seethc/IIB_project_FUTURE/CAD/Gemini_Generated_Image_v84o97v84o97v84o.png

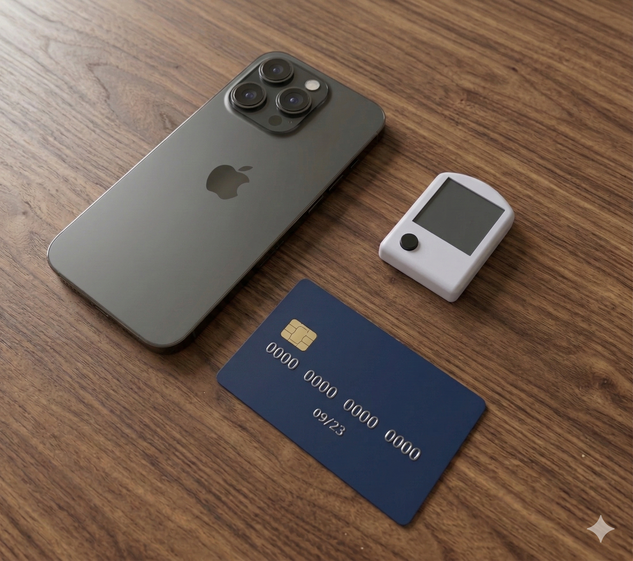
CAD/Gemini_Generated_Image_v84o97v84o97v84o.png
