seethc/IIB_project_FUTURE/misc_figures/current_sleep.png

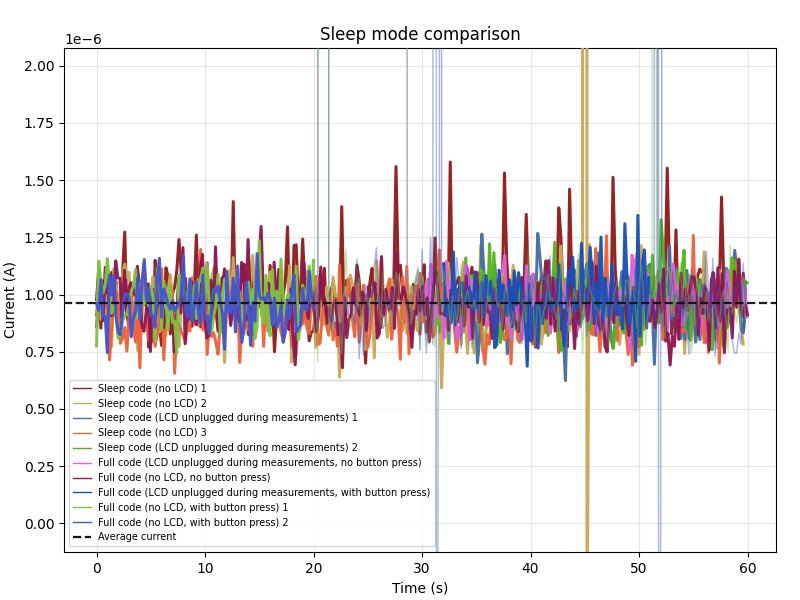
misc_figures/current_sleep.png
