seethc/IIB_project_FUTURE/README.md

# IIB_project_FUTURE
TOTP implementation for an ATtiny1616 based keyfob device and a Raspberry Pi based clinical-side backend.
