seethc/IIB_project_FUTURE/CAD/CompleteSystem.JPG

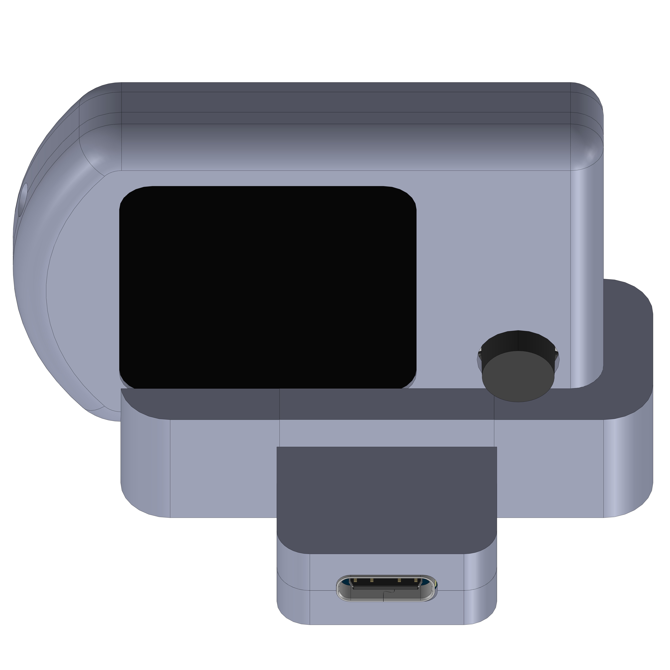
CAD/CompleteSystem.JPG
