seethc/IIB_project_FUTURE/CAD/CompleteSystemExploded.JPG

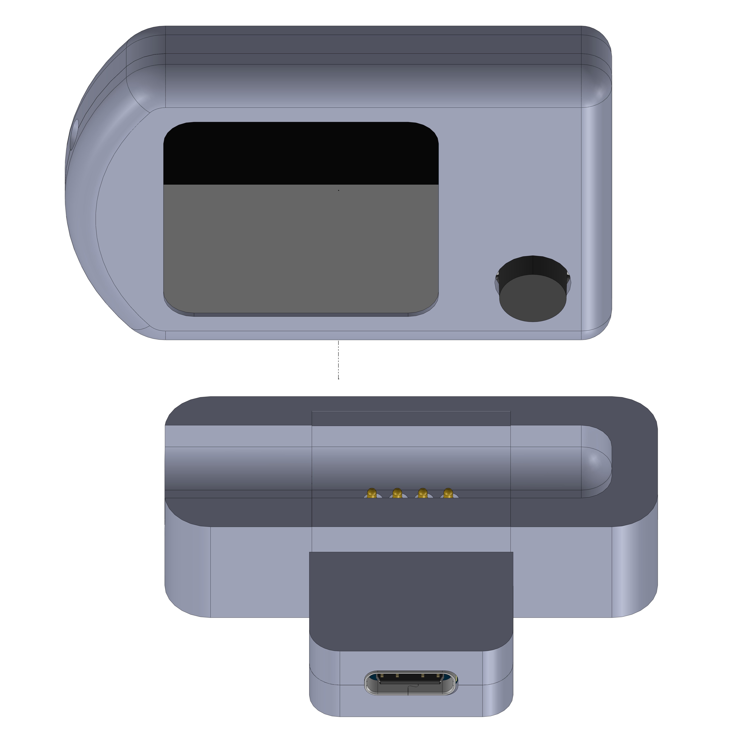
CAD/CompleteSystemExploded.JPG
