seethc/IIB_project_FUTURE/CAD/CompleteSystemTransparent.JPG

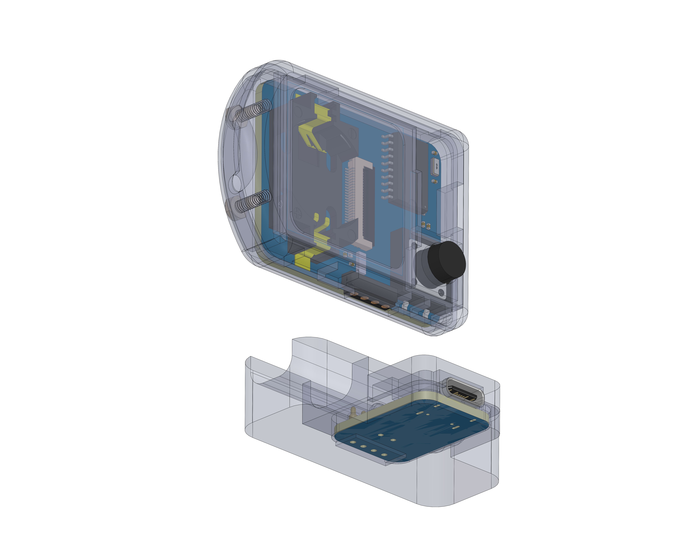
CAD/CompleteSystemTransparent.JPG
