seethc/IIB_project_FUTURE/CAD/DockedSystem.JPG

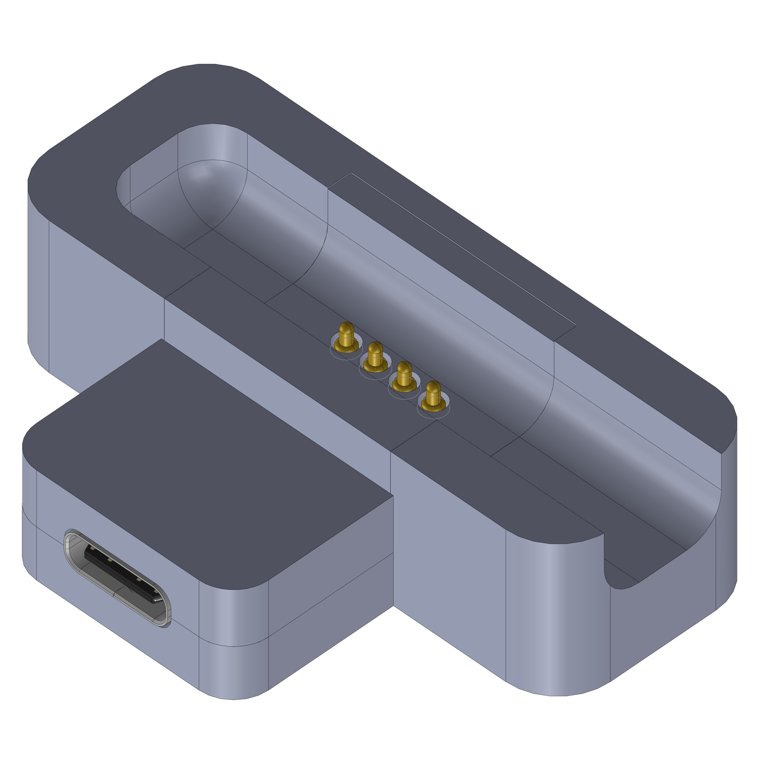
CAD/DockedSystem.JPG
