seethc/IIB_project_FUTURE/CAD/DockedSystemExploded.JPG

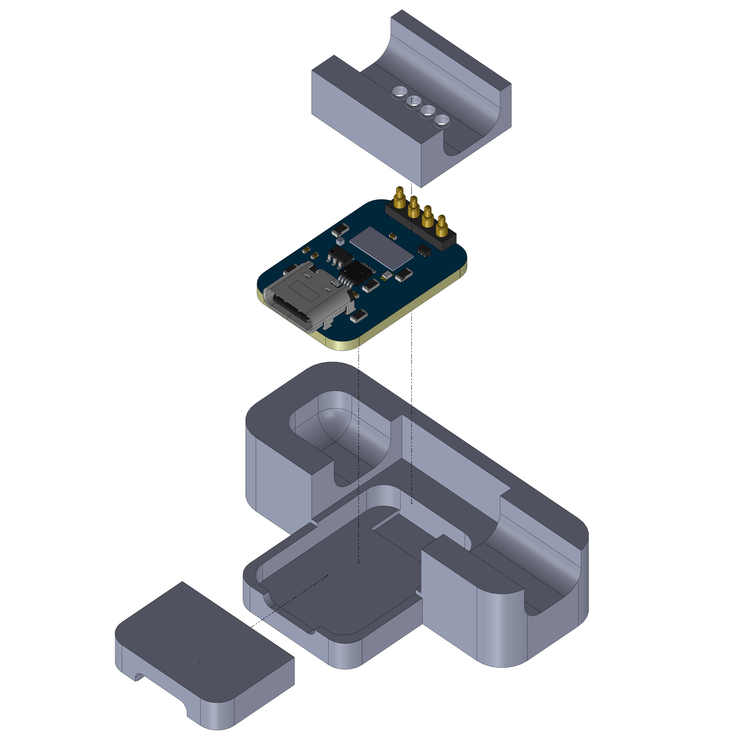
CAD/DockedSystemExploded.JPG
