seethc/IIB_project_FUTURE/CAD/IntegratedFob.JPG

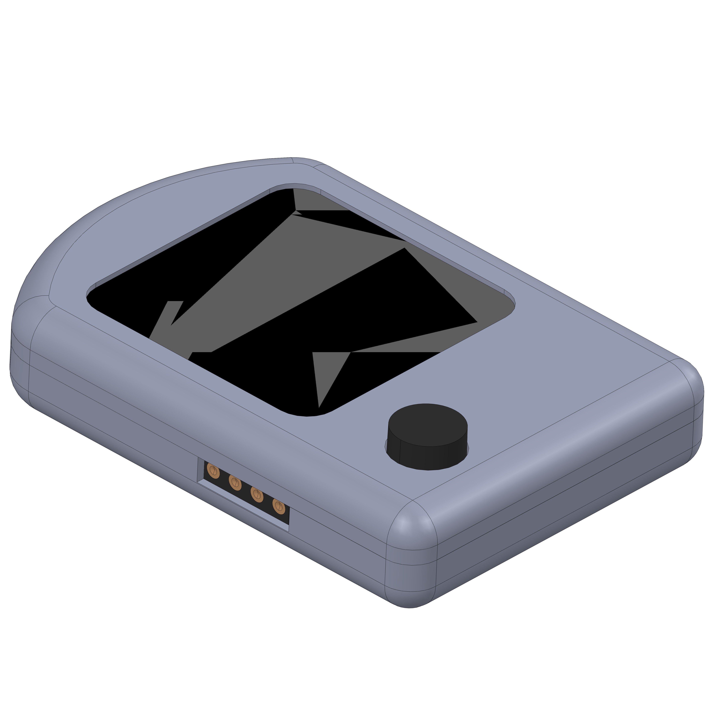
CAD/IntegratedFob.JPG
