seethc/IIB_project_FUTURE/CAD/IntegratedFobExploded.JPG

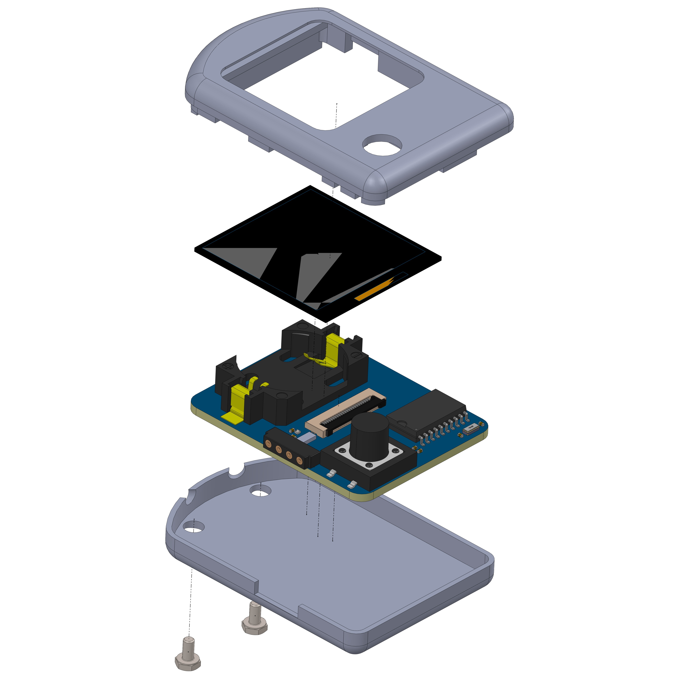
CAD/IntegratedFobExploded.JPG
