seethc/IIB_project_FUTURE/CAD/TransparentSystem.JPG

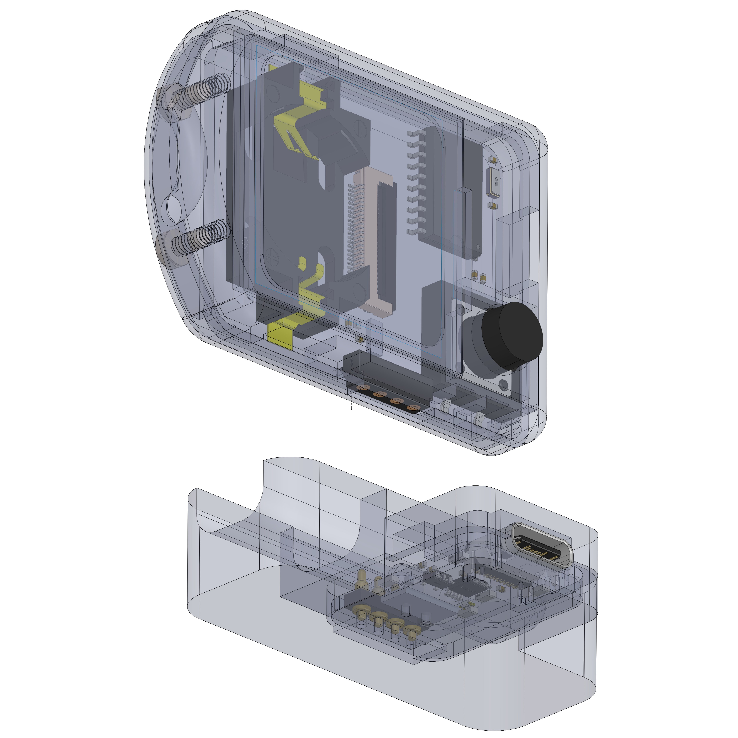
CAD/TransparentSystem.JPG
