seethc/IIB_project_FUTURE/misc_figures/combined.png

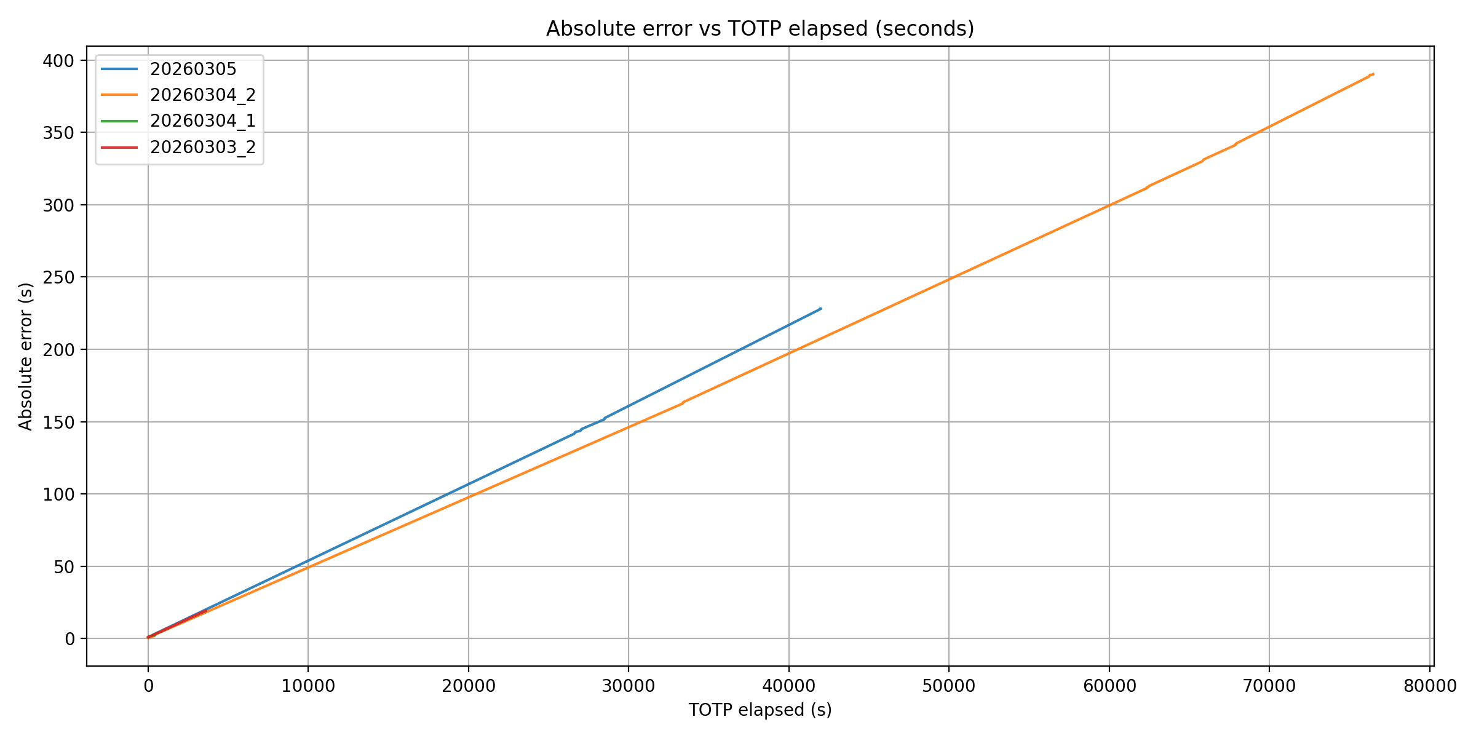
misc_figures/combined.png
