seethc/IIB_project_FUTURE/misc_figures/combined_rms.png

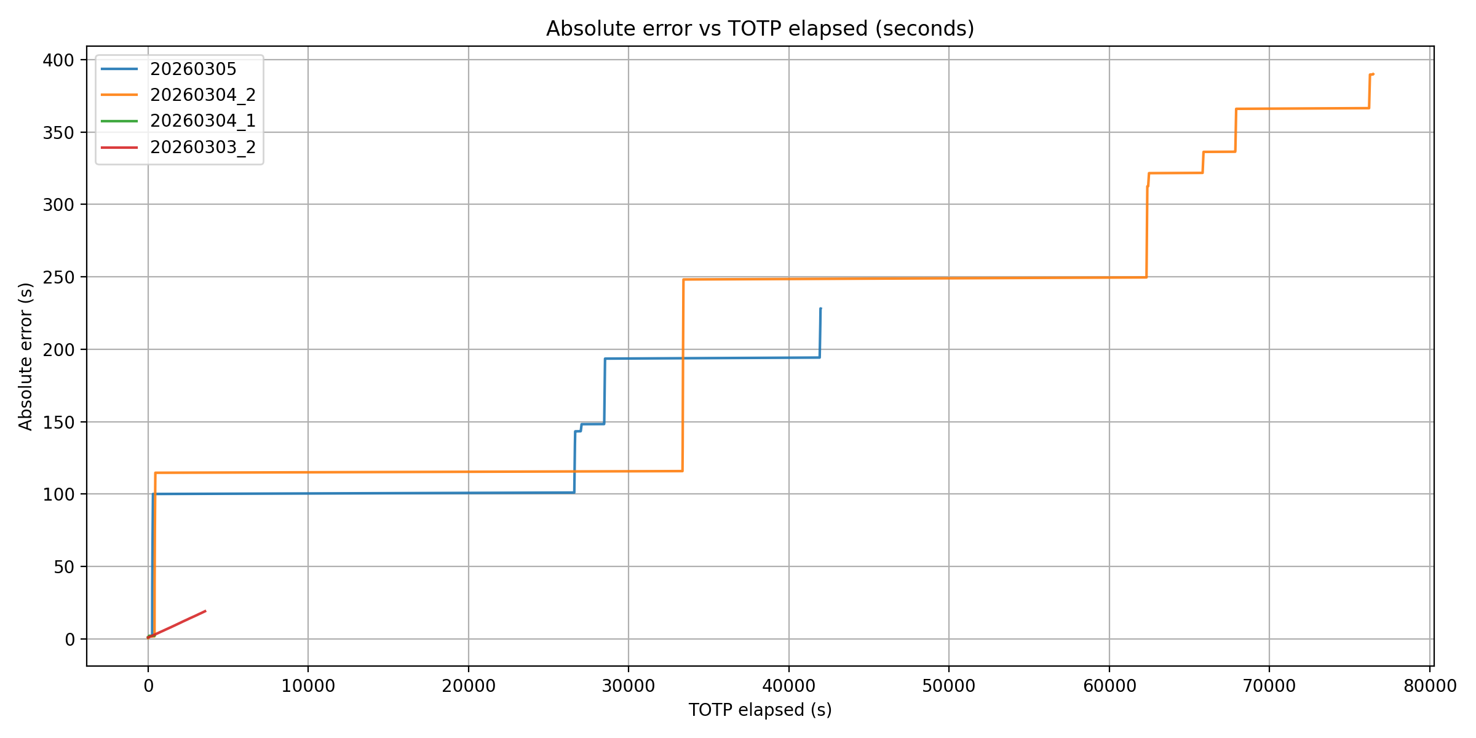
misc_figures/combined_rms.png
