seethc/IIB_project_FUTURE/misc_figures/current_crypto_display.png

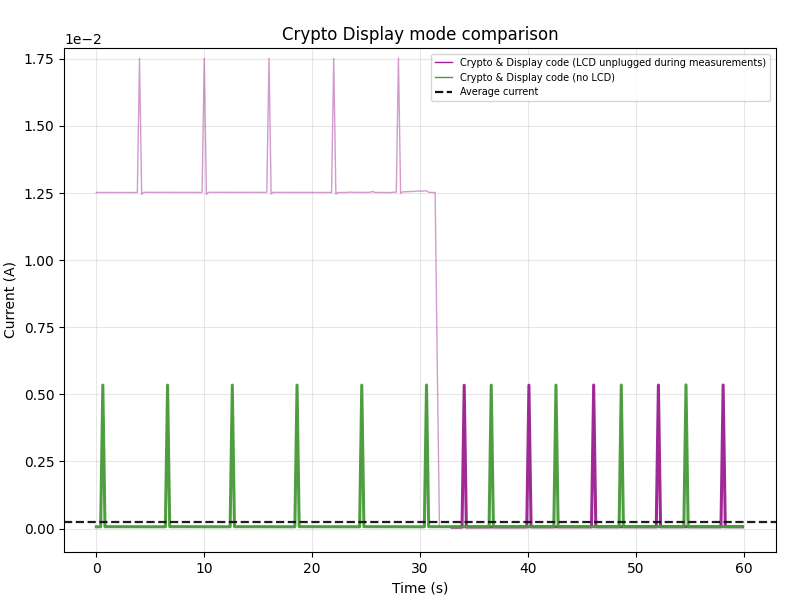
misc_figures/current_crypto_display.png
