seethc/IIB_project_FUTURE/misc_figures/current_crypto_only2.png

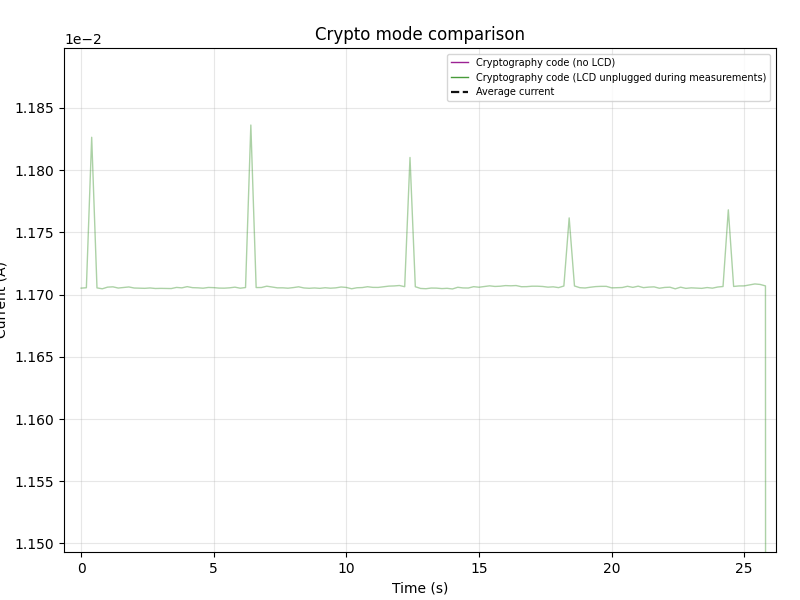
misc_figures/current_crypto_only2.png
