seethc/IIB_project_FUTURE/misc_figures/current_crypto_only.png

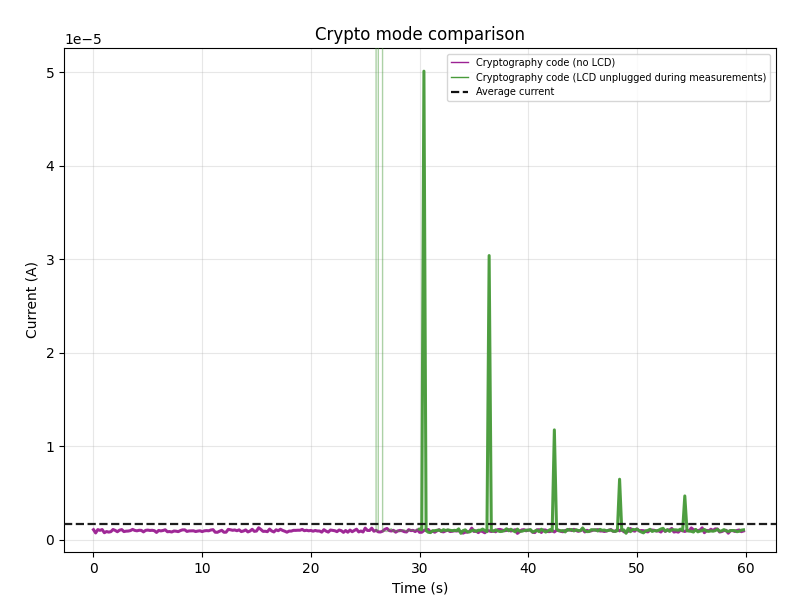
misc_figures/current_crypto_only.png
