seethc/IIB_project_FUTURE/misc_figures/current_numbers.png

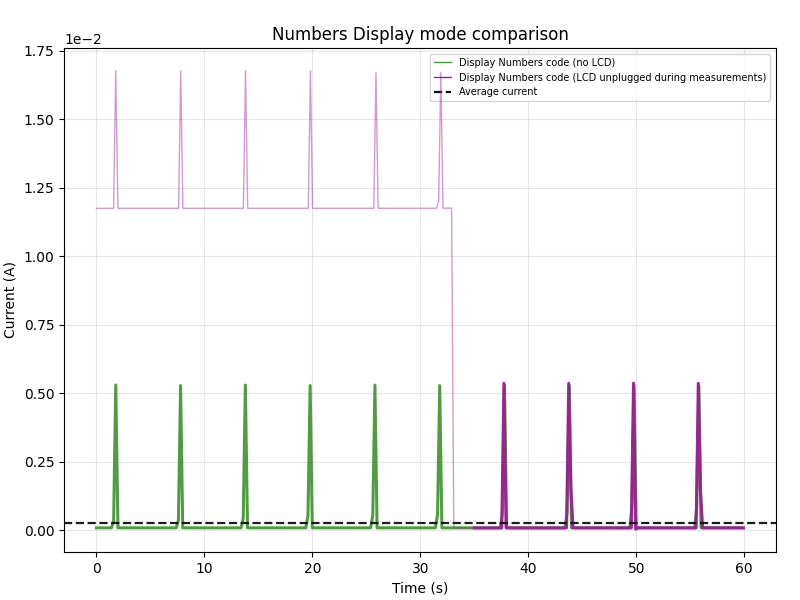
misc_figures/current_numbers.png
