seethc/IIB_project_FUTURE/misc_figures/current_shapes.png

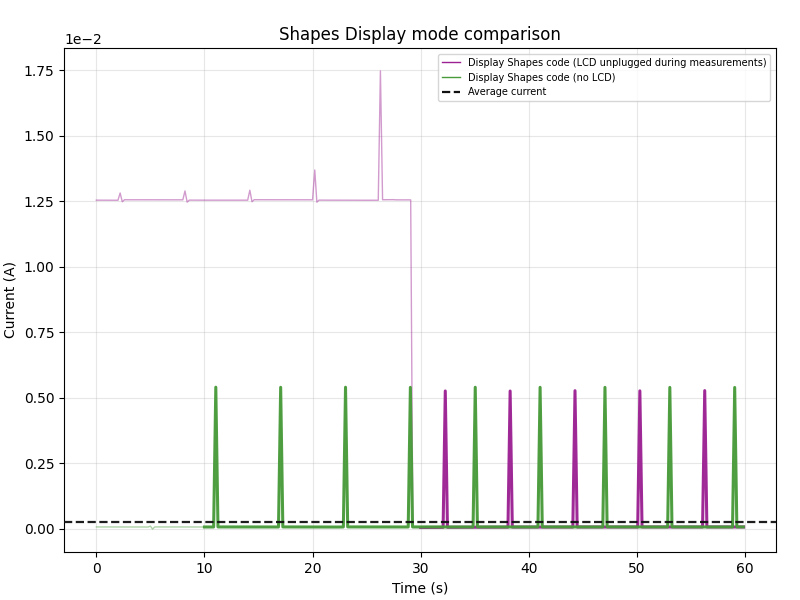
misc_figures/current_shapes.png
