seethc/IIB_project_FUTURE/misc_figures/Figure_1.png

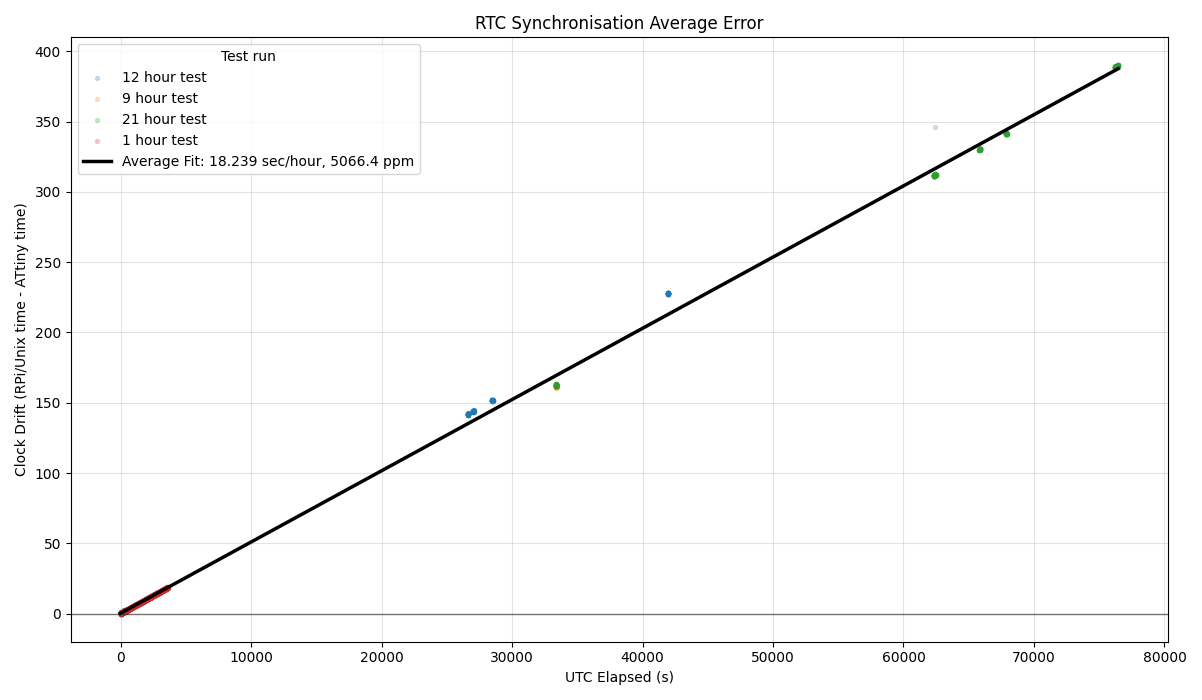
misc_figures/Figure_1.png
