seethc/IIB_project_FUTURE/misc_figures/Figure_2.png

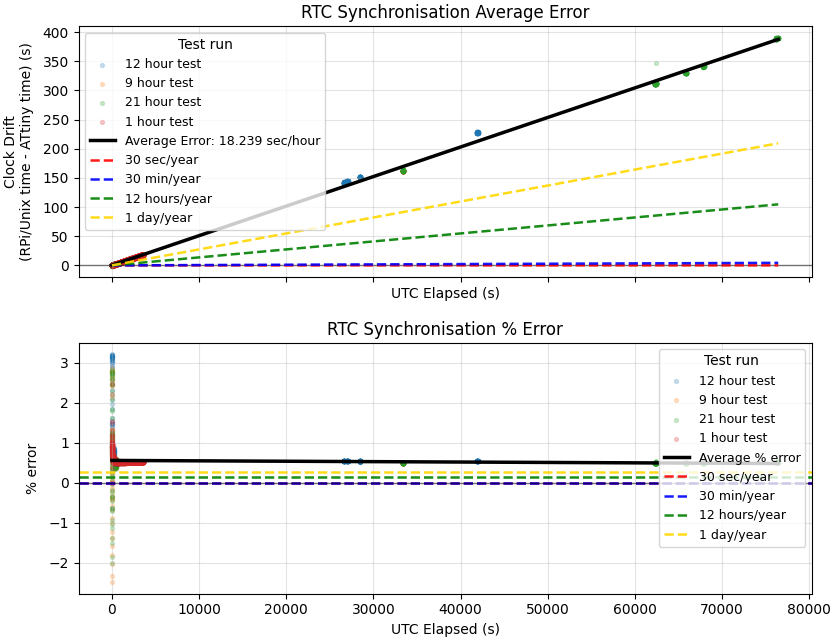
misc_figures/Figure_2.png
