seethc/IIB_project_FUTURE/misc_figures/Figure_2_tall.png

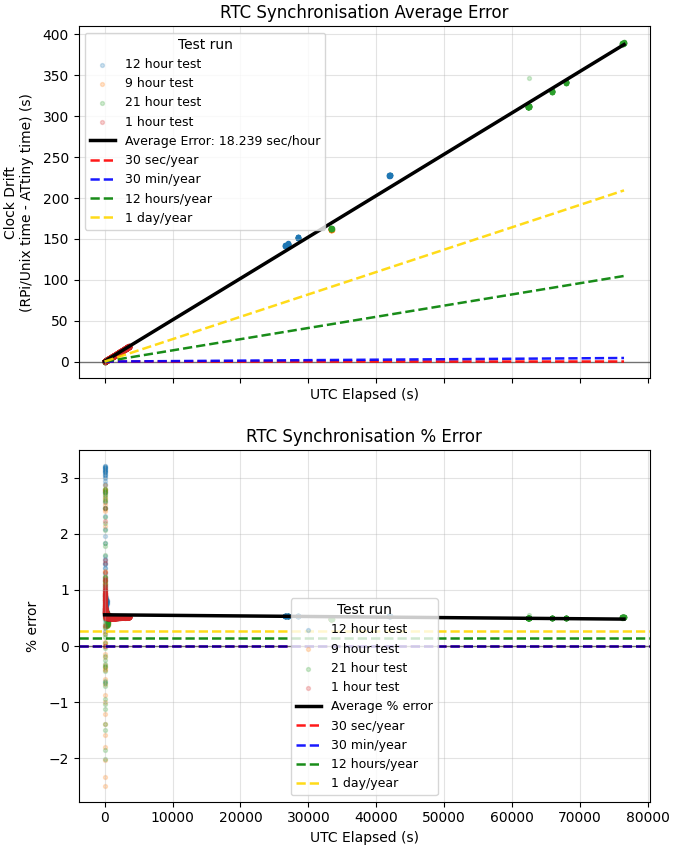
misc_figures/Figure_2_tall.png
