seethc/IIB_project_FUTURE/CAD/USB_case_top_alpha.STL

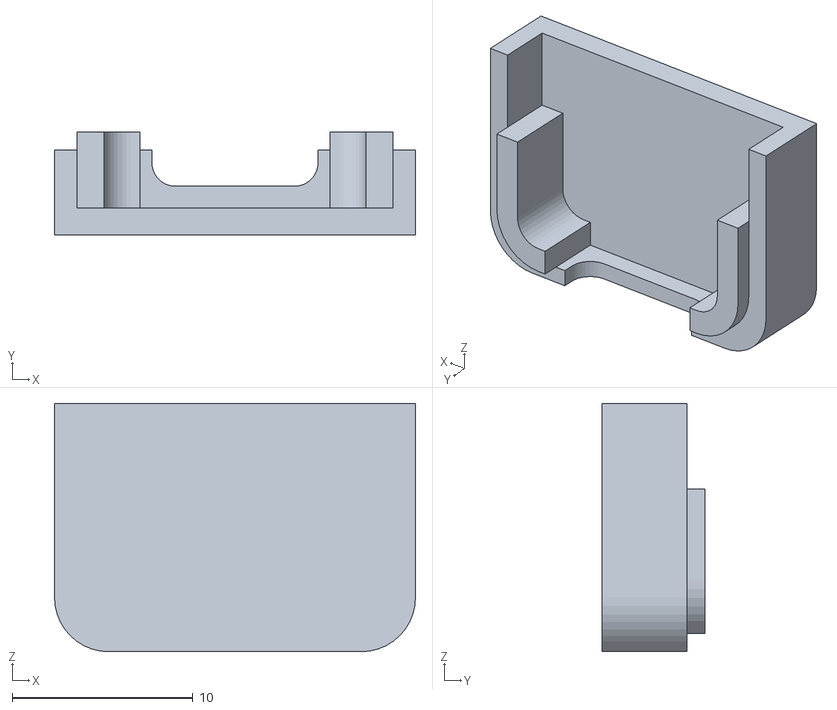
[picture p42: CAD file, 2026-05-31]
CAD/USB_case_top_alpha.STL
20.0 x 5.70 x 13.8
