seethc/IIB_project_FUTURE/CAD/LCD.SLDPRT

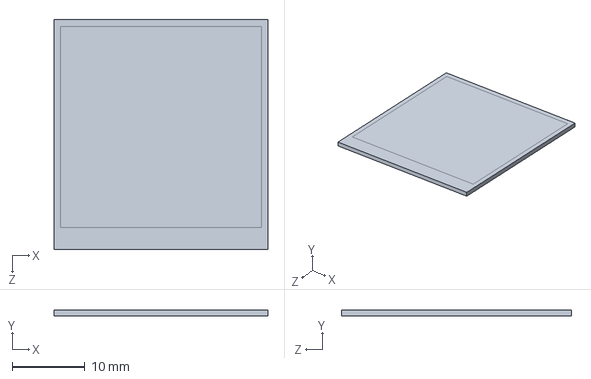
[picture p43: CAD file, 2026-05-31]
CAD/LCD.SLDPRT
29.5 x 0.8 x 31.7 mm
