seethc/IIB_project_FUTURE/CAD/USB_bottom.SLDPRT

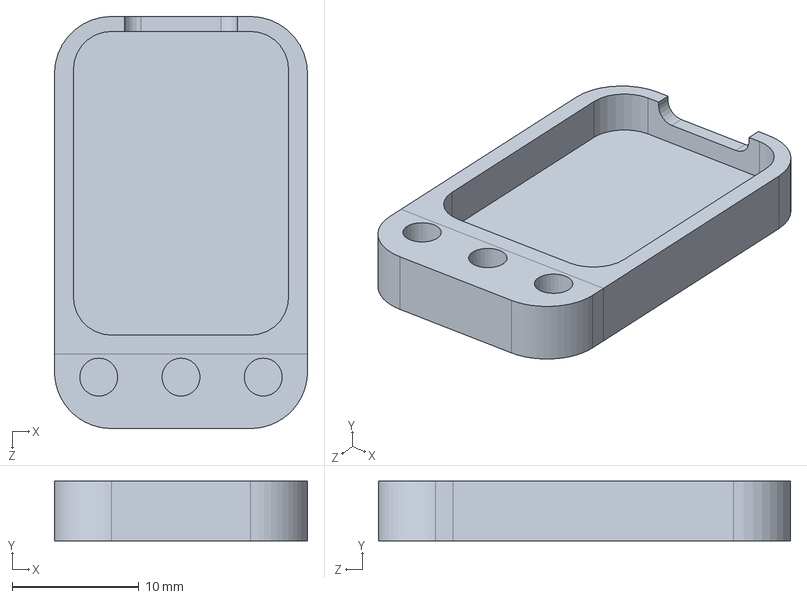
[picture p44: CAD file, 2026-05-31]
CAD/USB_bottom.SLDPRT
20.0 x 4.73 x 32.6 mm
