seethc/IIB_project_FUTURE/CAD/USB_case_bottom.SLDPRT

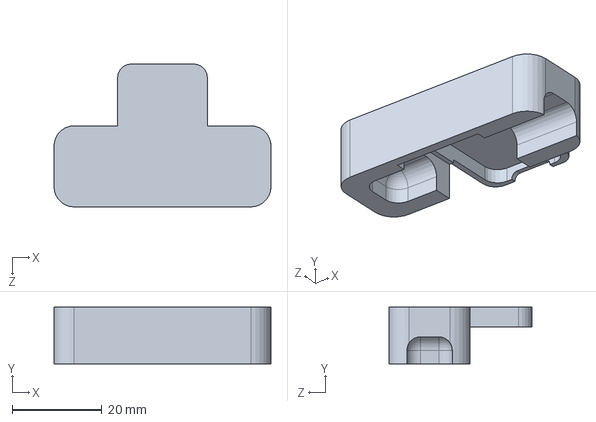
[picture p45: CAD file, 2026-05-31]
CAD/USB_case_bottom.SLDPRT
48.4 x 12.6 x 31.9 mm
