seethc/IIB_project_FUTURE/CAD/pendant_top_correct2.SLDPRT

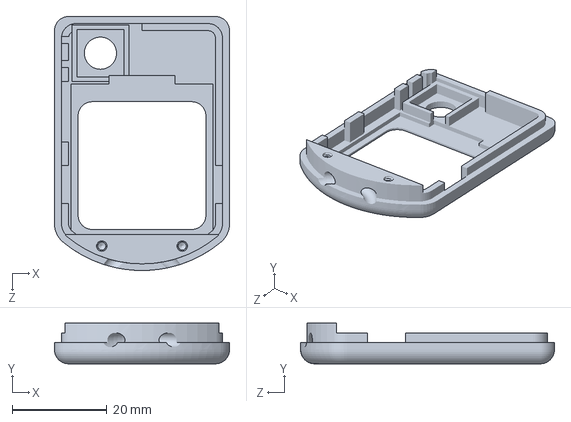
[picture p46: CAD file, 2026-05-31]
CAD/pendant_top_correct2.SLDPRT
37.0 x 8.60 x 53.7 mm
