seethc/IIB_project_FUTURE/CAD/lcd_base.SLDPRT

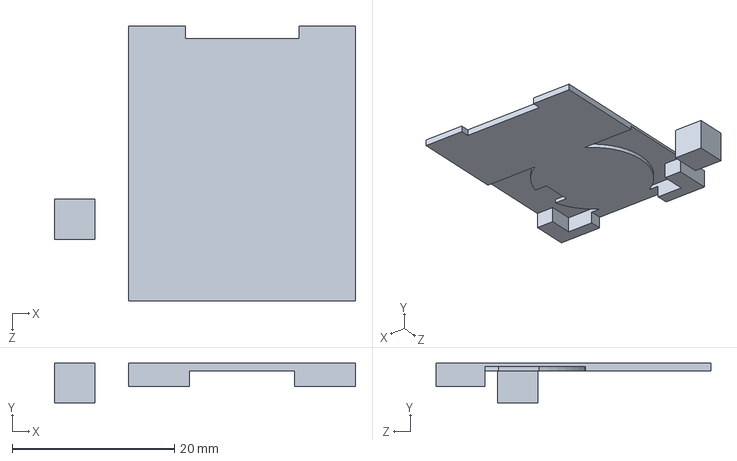
[picture p47: CAD file, 2026-05-31]
CAD/lcd_base.SLDPRT
37.1 x 4.90 x 33.9 mm
