seethc/IIB_project_FUTURE/CAD/pendant.SLDPRT

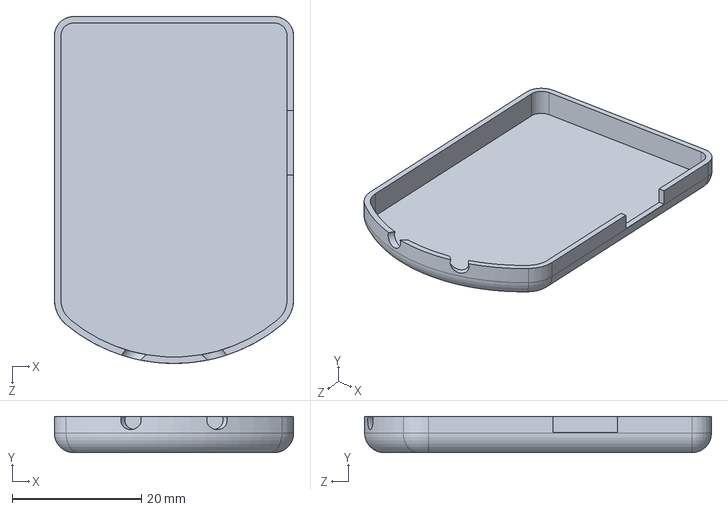
[picture p48: CAD file, 2026-05-31]
CAD/pendant.SLDPRT
37.0 x 5.60 x 53.7 mm
