seethc/IIB_project_FUTURE/CAD/UM3E_pendant.3mf

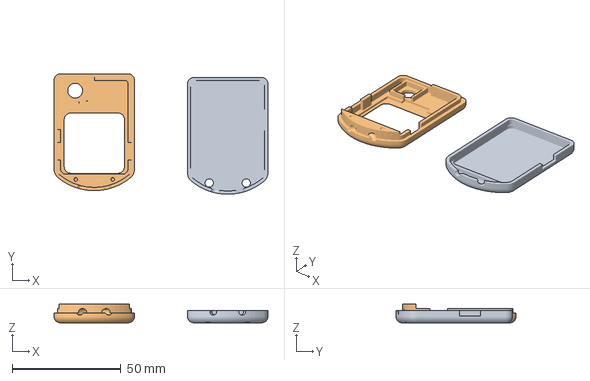
[picture p49: CAD file, 2026-05-31]
CAD/UM3E_pendant.3mf
98.3 x 55.3 x 8.60 mm
pendant.STL
pendant_top_correct.STL
