seethc/IIB_project_FUTURE/CAD/pendant_top_alpha.STL

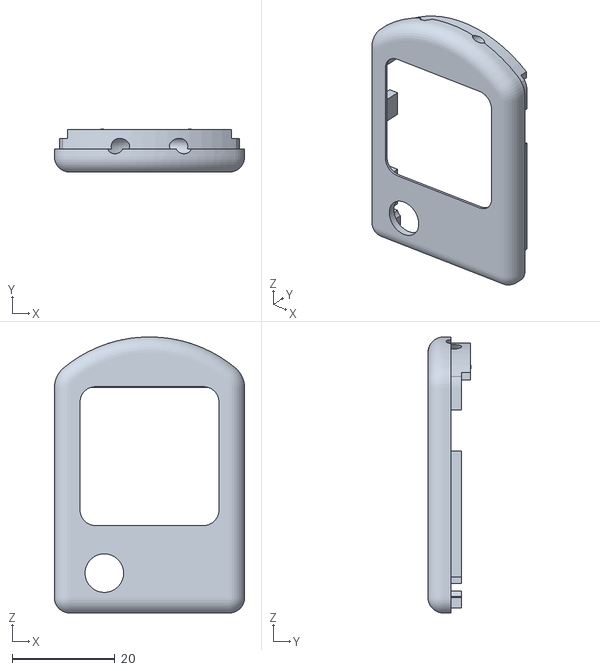
[picture p50: CAD file, 2026-05-31]
CAD/pendant_top_alpha.STL
37.0 x 8.39 x 53.6
