seethc/IIB_project_FUTURE/CAD/pendant_top.SLDPRT

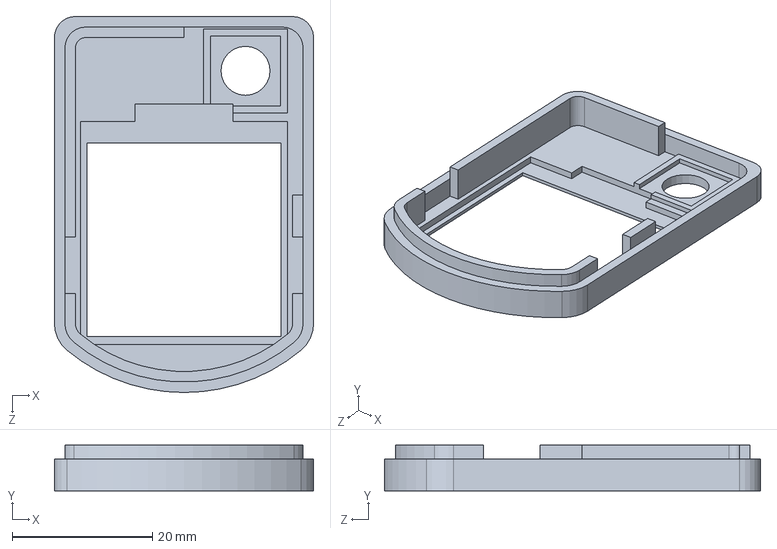
[picture p51: CAD file, 2026-05-31]
CAD/pendant_top.SLDPRT
37.0 x 6.50 x 53.7 mm
