seethc/IIB_project_FUTURE/CAD/3D_PCB_PCB_3216_fob_compact_2026-03-06_2026-03-06.step

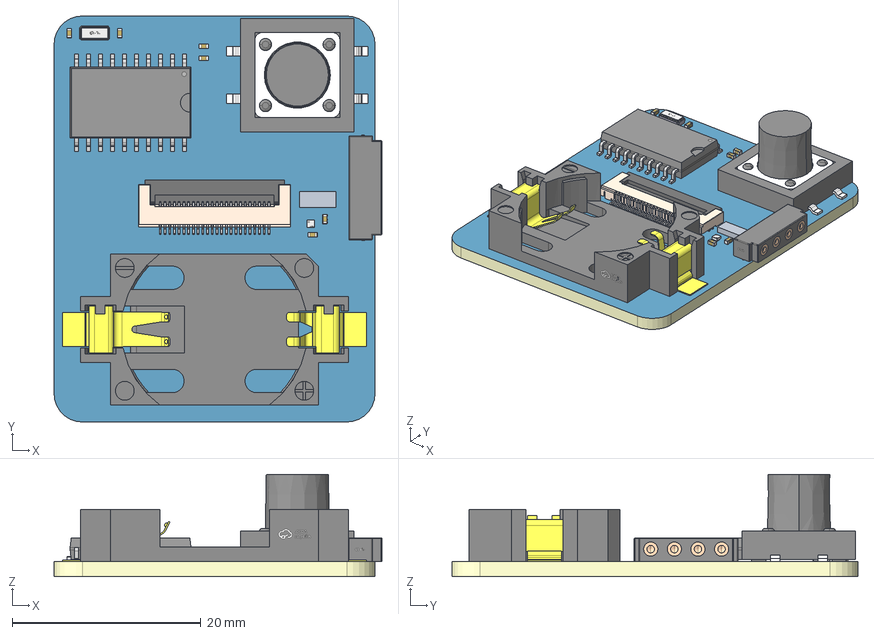
[picture p52: CAD file, 2026-05-31]
CAD/3D_PCB_PCB_3216_fob_compact_2026-03-06_2026-03-06.step
34.7 x 43.0 x 10.8 mm
Board~JCCK
TopCopper~JCCK
BottomCopper~JCCK
TopFpcStiffener~JCCK
BottomFpcStiffener~JCCK
SOD-123_L2.7-W1.6-LS3.7-RD-1~SOD-123_L2.7-W1.6-LS3.7-RD-1~JCCK
SOIC-20_L12.8-W7.5-P1.27-LS10.3-BL~SOIC-20_ L12.8-W7.5-P1.27-LS10.3-BL~JCCK
WLCSP-4_L0.8-W0.8-R2-C2-P0.40-BL~WLCSP-4_L0.8-W0.8-H0.6-P0.4~JCCK
C0402~C0402_L1.0-W0.5-H0.5~JCCK x 6
CONN-SMD_YZ199315035T-04025-01~CONN-SMD_YZ199315035T-04025-01~JCCK
OSC-SMD_L3.2-W1.5~OSC-SMD_L3.2-W1.5-H0.8~JCCK
SW-SMD_4P-L12.0-W12.0-P5.00-LS15.0~SW-SMD_ 4P-L12.0-W12.0-P5.00-LS15.0~JCCK
BAT-SMD_CR2032-B1~BAT-SMD_CR2032-B1~JCCK
FPC-SMD_24P-P0.50_C5373439~FPC-SMD_24P-P0.50_C5373439~JCCK
