seethc/IIB_project_FUTURE/CAD/USB_pendant_holder.SLDPRT

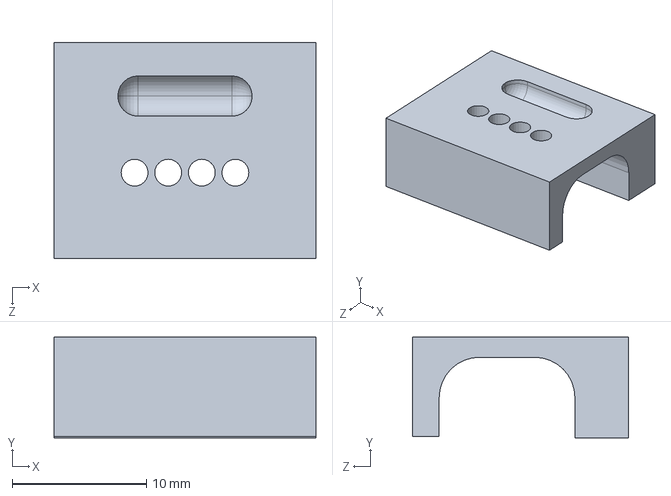
[picture p54: CAD file, 2026-05-31]
CAD/USB_pendant_holder.SLDPRT
19.5 x 7.50 x 16.1 mm
