seethc/IIB_project_FUTURE/CAD/USB_top.SLDPRT

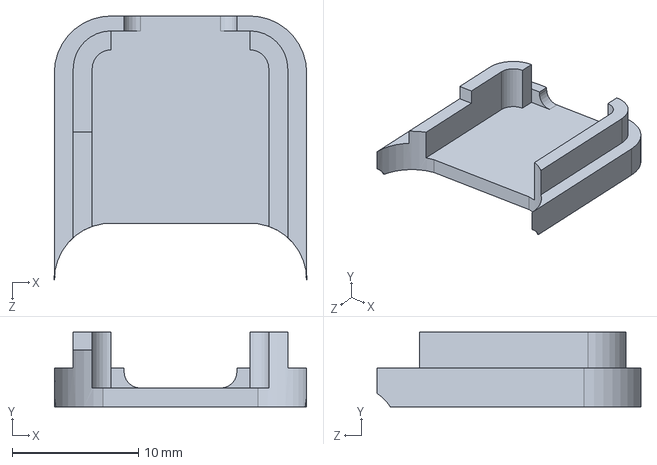
[picture p55: CAD file, 2026-05-31]
CAD/USB_top.SLDPRT
20.0 x 5.94 x 20.9 mm
