seethc/IIB_project_FUTURE/CAD/scale_model_comparison.3mf

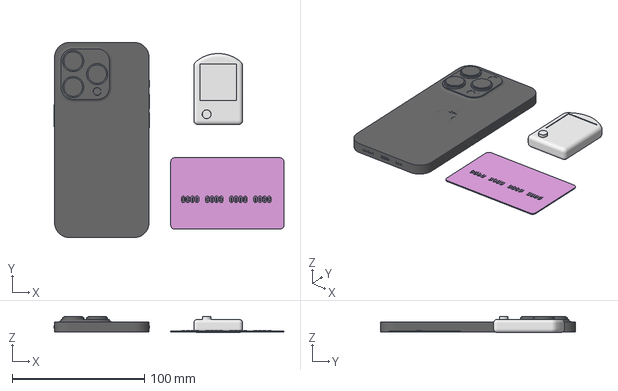
[picture p56: CAD file, 2026-05-31]
CAD/scale_model_comparison.3mf
173.8 x 147.5 x 12.3 mm
