seethc/IIB_project_FUTURE/CAD/3D_PCB_PCB_FUTURE_USB_adapter_2026-03-09_2026-03-09.step

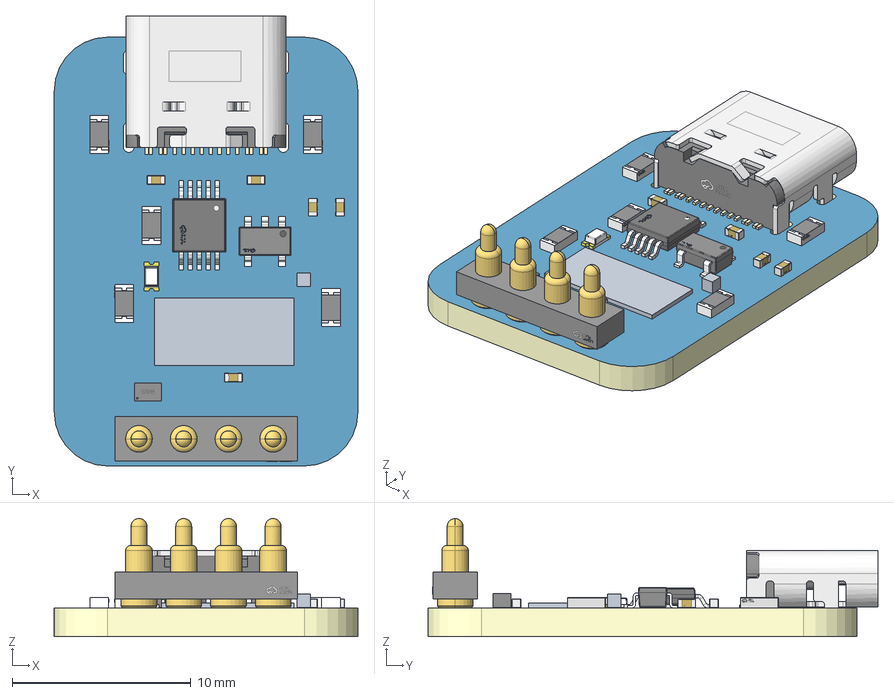
[picture p57: CAD file, 2026-05-31]
CAD/3D_PCB_PCB_FUTURE_USB_adapter_2026-03-09_2026-03-09.step
17.0 x 25.2 x 6.60 mm
Board~5WUN
TopCopper~5WUN
BottomCopper~5WUN
TopFpcStiffener~5WUN
BottomFpcStiffener~5WUN
C0402~C0402_L1.0-W0.5-H0.5~5WUN x 5
SW-SMD_MSS12C02LS-HB2.0-1~SW-SMD_MSS12C02LS-HB2.0-1~5WUN
MSOP-10_L3.0-W3.0-P0.50-LS5.0-BL~MSOP-10_ L3.0-W3.0-H1.1-LS5.0-P0.50~5WUN
R0603~R0603~5WUN x 5
LED0603-R-RD_WHITE~LED0603-R-RD_WHITE~5WUN
LED0603-RD~LED0603-RD~5WUN
SOT-23-5_L2.9-W1.6-P0.95-LS2.7-BR~SOT-23-5_ L2.9-W1.6-P0.95-LS2.7-BR~5WUN
DFN-6_L1.5-W1.0-P0.50-BL~DFN-6_L1.5-W1.0-H0.7-P0.50~5WUN
CONN-TH_YZ85915058P-04025-01~CONN-TH_YZ85915058P-04025-01~5WUN
TYPE-C-SMD_TYPE-C-3.1-16PIN~TYPE-C-SMD_TYPE-C-3.1-16PIN~5WUN
