seethc/IIB_project_FUTURE/CAD/DockedSystem.SLDASM

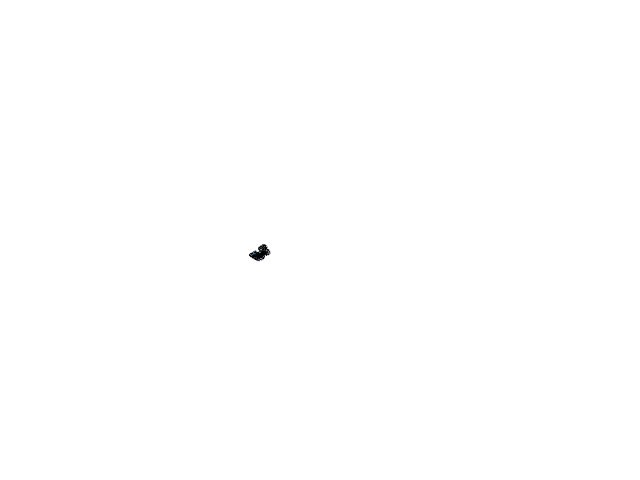
[picture p58: CAD file, 2026-05-31]
CAD/DockedSystem.SLDASM
C0402~C0402_L1.0-W0.5-H0.5~5WUN.step x 5
SW-SMD_MSS12C02LS-HB2.0-1~SW-SMD_MSS12C02LS-HB2.0-1~5WUN.step
MSOP-10_L3.0-W3.0-P0.50-LS5.0-BL~MSOP-10_L3.0-W3.0-H1.1-LS5.0-P0.50~5WUN.step
R0603~R0603~5WUN.step x 5
LED0603-R-RD_WHITE~LED0603-R-RD_WHITE~5WUN.step
LED0603-RD~LED0603-RD~5WUN.step
SOT-23-5_L2.9-W1.6-P0.95-LS2.7-BR~SOT-23-5_L2.9-W1.6-P0.95-LS2.7-BR~5WUN.step
DFN-6_L1.5-W1.0-P0.50-BL~DFN-6_L1.5-W1.0-H0.7-P0.50~5WUN.step
CONN-TH_YZ85915058P-04025-01~CONN-TH_YZ85915058P-04025-01~5WUN.step
TYPE-C-SMD_TYPE-C-3.1-16PIN~TYPE-C-SMD_TYPE-C-3.1-16PIN~5WUN.step
Board~5WUN.step
pendant
SOD-123_L2.7-W1.6-LS3.7-RD-1~SOD-123_L2.7-W1.6-LS3.7-RD-1~JCCK.step
SOIC-20_L12.8-W7.5-P1.27-LS10.3-BL~SOIC-20_L12.8-W7.5-P1.27-LS10.3-BL~JCCK.step
WLCSP-4_L0.8-W0.8-R2-C2-P0.40-BL~WLCSP-4_L0.8-W0.8-H0.6-P0.4~JCCK.step
C0402~C0402_L1.0-W0.5-H0.5~JCCK.step x 6
CONN-SMD_YZ199315035T-04025-01~CONN-SMD_YZ199315035T-04025-01~JCCK.step
OSC-SMD_L3.2-W1.5~OSC-SMD_L3.2-W1.5-H0.8~JCCK.step
SW-SMD_4P-L12.0-W12.0-P5.00-LS15.0~SW-SMD_4P-L12.0-W12.0-P5.00-LS15.0~JCCK.step
BAT-SMD_CR2032-B1~BAT-SMD_CR2032-B1~JCCK.step
FPC-SMD_24P-P0.50_C5373439~FPC-SMD_24P-P0.50_C5373439~JCCK.step
Board~JCCK.step
LCD
pendant_top_correct
hex screw gradeab_iso x 2
USB_pendant_holder
USB_case_top
USB_case_bottom_mirror
