seethc/IIB_project_FUTURE/CAD/USB_casing.SLDASM

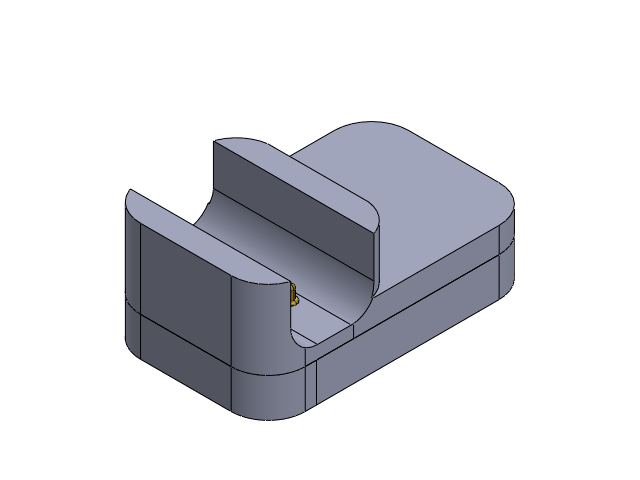
[picture p60: CAD file, 2026-05-31]
CAD/USB_casing.SLDASM
USB_bottom
C0402~C0402_L1.0-W0.5-H0.5~5WUN.step x 5
SW-SMD_MSS12C02LS-HB2.0-1~SW-SMD_MSS12C02LS-HB2.0-1~5WUN.step
MSOP-10_L3.0-W3.0-P0.50-LS5.0-BL~MSOP-10_L3.0-W3.0-H1.1-LS5.0-P0.50~5WUN.step
R0603~R0603~5WUN.step x 5
LED0603-R-RD_WHITE~LED0603-R-RD_WHITE~5WUN.step
LED0603-RD~LED0603-RD~5WUN.step
SOT-23-5_L2.9-W1.6-P0.95-LS2.7-BR~SOT-23-5_L2.9-W1.6-P0.95-LS2.7-BR~5WUN.step
DFN-6_L1.5-W1.0-P0.50-BL~DFN-6_L1.5-W1.0-H0.7-P0.50~5WUN.step
CONN-TH_YZ85915058P-04025-01~CONN-TH_YZ85915058P-04025-01~5WUN.step
TYPE-C-SMD_TYPE-C-3.1-16PIN~TYPE-C-SMD_TYPE-C-3.1-16PIN~5WUN.step
Board~5WUN.step
USB_top
