seethc/IIB_project_FUTURE/(list of files, cad)

Other CAD files:
CAD/pendant_bottom_final.STL
CAD/USB_case_top.SLDPRT
CAD/pendant_top_correct.SLDPRT
CAD/pendant_alpha.STL
CAD/USB_pendant_holder_alpha.STL
CAD/USB_case_bottom_alpha.STL
CAD/USB_case_bottom_mirror.SLDPRT
CAD/3D_PCB_PCB_3216_fob_compact_2026-03-06_2026-03-06.SLDASM
CAD/3D_PCB_PCB_3216_fob_compact_2026-03-06_2026-03-06.SLDDRW
CAD/3D_PCB_PCB_FUTURE_USB_adapter_2026-03-09_2026-03-09.SLDASM
CAD/3D_PCB_PCB_FUTURE_USB_adapter_2026-03-09_2026-03-09.SLDDRW
CAD/DockedSystem.SLDDRW
CAD/IntegratedFob.SLDDRW
CAD/IntegratedFob.SLDPRT
CAD/IntegratedFob.STL
CAD/USB_bottom.STL
CAD/USB_case_bottom.STL
CAD/USB_case_top.STL
CAD/USB_pendant_holder.3mf
CAD/USB_pendant_holder.STL
CAD/USB_top.3mf
CAD/USB_top.STL
CAD/lcd_base.STL
CAD/pendant.3mf
CAD/pendant.STL
CAD/pendant_top_correct.STL
CAD/pendant_top_correct2.STL
