seethc/IIB_project_FUTURE/VirtualBench_power_tests/FUTURE Calcs - Power.completed.csv

File | Total raw charge (mC) | Worst-case Min (mC) | Worst-case Max (mC) | Statistical Min (mC) | Statistical Max (mC) | Current Floor (A) | Area above floor (mC) | Worst-case Min (mC) | Worst-case Max (mC) | Statistical Min (mC) | Statistical Max (mC)
[01] current_log_20260326_154908.csv | sleep_only.ino with LCD unplugged halfway through | 316.958130 | 314.613744 | 319.302560 | 316.131224 | 317.785036 | 0.0000010190 | 316.898512 | 314.554867 | 319.242188 | 316.071654 | 317.725371
[02] current_log_20260326_155546.csv | sleep_with_overflow (PER = 19 so overflows every 20 ticks or 5s) no LCD | 0.060393 | 0.057824 | 0.063076 | 0.060262 | 0.060524 | 0.0000010069 | 0.002423 | 0.001089 | 0.003801 | 0.002349 | 0.002497
[04] current_log_20260326_155840.csv | sleep_with_overflow (PER = 19 so [05] overflows every 20 ticks or 5s) with LCD unplugged halfway through | 357.258018 | 354.909497 | 359.606587 | 356.435440 | 358.080597 | 0.0000009821 | 357.200248 | 354.852446 | 359.548076 | 356.377717 | 358.022779
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
