seethc/IIB_project_FUTURE/rtc_test_files/20260304_1/attiny_log_9h.xlsx

UTC Timestamp | TOTP Code | Elapsed HH:MM:SS | Elapsed (s) | UTC elapsed | CLK elapsed | Elapsed s
0:13:03 | 755224 | 0:00:00 | 0 | 9:16:52 | 9:15:03 | 9:15:03
0:13:05 | 287082 | 0:00:54 | 54
0:13:06 | 287082 | 0:00:55 | 55 | Error | % Error
0:13:07 | 287082 | 0:00:56 | 56 | 0:01:49 | 0.32686%
0:13:08 | 287082 | 0:00:57 | 57
0:13:09 | 287082 | 0:00:58 | 58 | Window | Time till TOTP desync
0:13:10 | 287082 | 0:00:59 | 59 | 1s | 0.003541025482 | 0d00:05:06
0:13:11 | 359152 | 0:01:00 | 60 | 60s | 0.2124615289 | 0d05:05:57
0:13:12 | 359152 | 0:01:01 | 61 | 30m | 6.373845867 | 6d08:58:20
0:13:13 | 359152 | 0:01:02 | 62 | 1h | 12.74769173 | 12d17:56:41
0:13:14 | 359152 | 0:01:03 | 63 | 6h | 76.4861504 | 76d11:40:03
0:13:15 | 359152 | 0:01:04 | 64 | 12h | 152.9723008 | 152d23:20:07
0:13:16 | 359152 | 0:01:05 | 65 | Daily | 305.94 | 305d22:40:14
0:13:17 | 359152 | 0:01:06 | 66
0:13:18 | 359152 | 0:01:07 | 67
0:13:19 | 359152 | 0:01:08 | 68 | Using the ULP internal CLK
0:13:20 | 359152 | 0:01:09 | 69
0:13:21 | 359152 | 0:01:10 | 70
0:13:22 | 359152 | 0:01:11 | 71
0:13:23 | 359152 | 0:01:12 | 72
0:13:24 | 359152 | 0:01:14 | 74
0:13:25 | 359152 | 0:01:15 | 75
0:13:26 | 359152 | 0:01:16 | 76
0:13:27 | 359152 | 0:01:17 | 77
0:13:28 | 359152 | 0:01:18 | 78
0:13:29 | 359152 | 0:01:19 | 79
0:13:30 | 359152 | 0:01:20 | 80
0:13:31 | 359152 | 0:01:21 | 81
0:13:32 | 359152 | 0:01:22 | 82
0:13:33 | 359152 | 0:01:23 | 83
0:13:34 | 359152 | 0:01:24 | 84
0:13:35 | 359152 | 0:01:25 | 85
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
9:29:34 | 461650 | 9:14:41 | 33281
9:29:35 | 461650 | 9:14:42 | 33282
9:29:36 | 461650 | 9:14:43 | 33283
9:29:37 | 461650 | 9:14:44 | 33284
9:29:38 | 461650 | 9:14:45 | 33285
9:29:39 | 461650 | 9:14:46 | 33286
9:29:40 | 461650 | 9:14:47 | 33287
9:29:41 | 461650 | 9:14:48 | 33288
9:29:42 | 461650 | 9:14:49 | 33289
9:29:43 | 461650 | 9:14:50 | 33290
9:29:44 | 461650 | 9:14:51 | 33291
9:29:45 | 461650 | 9:14:52 | 33292
9:29:46 | 461650 | 9:14:53 | 33293
9:29:47 | 461650 | 9:14:54 | 33294
9:29:48 | 461650 | 9:14:55 | 33295
9:29:49 | 461650 | 9:14:57 | 33297
9:29:51 | 461650 | 9:14:58 | 33298
9:29:52 | 461650 | 9:14:59 | 33299
9:29:53 | 942390 | 9:15:00 | 33300
9:29:54 | 942390 | 9:15:01 | 33301
9:29:55 | 942390 | 9:15:02 | 33302
9:29:56 | 942390 | 9:15:03 | 33303
