seethc/IIB_project_FUTURE/rtc_test_files/20260304_1/totp_log_9h.xlsx

SYS UTC (INTERNET) | TOTP CODE | RTC TIME | ELAPSED (s) | UTC elapsed | RTC elapsed | Elapsed s
23:37:30 | 755224 | 12:04:41 | 0 | 9:54:28 | 9:54:28 | 9:54:28
23:37:31 | 755224 | 12:04:42 | 1
23:37:32 | 755224 | 12:04:43 | 2 | Error | % Error
23:37:33 | 755224 | 12:04:44 | 3 | 0:00:00 | 3.733875382e-10%
23:37:34 | 755224 | 12:04:45 | 4
23:37:35 | 755224 | 12:04:46 | 5 | Window | Time till TOTP desync
23:37:36 | 755224 | 12:04:47 | 6 | 1s | 3099748.355 | 3099748d08:31:16
23:37:37 | 755224 | 12:04:48 | 7 | 60s | 185984901.3 | 185984901d07:16:11
23:37:38 | 755224 | 12:04:49 | 8 | 30m | 5579547039 | 5579547039d02:05:42
23:37:39 | 755224 | 12:04:50 | 9 | 1h | 1.115909408e+10 | 11159094078d04:11:25
23:37:40 | 755224 | 12:04:51 | 10 | 6h | 6.695456447e+10 | 66954564469d01:08:27
23:37:41 | 755224 | 12:04:52 | 11 | 12h | 1.339091289e+11 | 133909128938d02:16:53
23:37:42 | 755224 | 12:04:53 | 12 | Daily | 267818257876.19 | 267818257876d04:33:47
23:37:43 | 755224 | 12:04:54 | 13
23:37:44 | 755224 | 12:04:55 | 14
23:37:45 | 755224 | 12:04:56 | 15
23:37:46 | 755224 | 12:04:57 | 16
23:37:47 | 755224 | 12:04:58 | 17
23:37:48 | 755224 | 12:04:59 | 18
23:37:49 | 755224 | 12:05:00 | 19
23:37:50 | 755224 | 12:05:01 | 20
23:37:51 | 755224 | 12:05:02 | 21
23:37:52 | 755224 | 12:05:03 | 22
23:37:53 | 755224 | 12:05:04 | 23
23:37:54 | 755224 | 12:05:05 | 24
23:37:55 | 755224 | 12:05:06 | 25
23:37:56 | 755224 | 12:05:07 | 26
23:37:57 | 755224 | 12:05:08 | 27
23:37:58 | 755224 | 12:05:09 | 28
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
0:33:43 | 702014 | 13:00:54 | 3373
0:33:44 | 702014 | 13:00:55 | 3374
0:33:45 | 702014 | 13:00:56 | 3375
0:33:46 | 702014 | 13:00:57 | 3376
0:33:47 | 702014 | 13:00:58 | 3377
0:33:48 | 702014 | 13:00:59 | 3378
0:33:49 | 702014 | 13:01:00 | 3379
0:33:50 | 702014 | 13:01:01 | 3380
0:33:51 | 702014 | 13:01:02 | 3381
0:33:52 | 702014 | 13:01:03 | 3382
0:33:53 | 702014 | 13:01:04 | 3383
0:33:54 | 702014 | 13:01:05 | 3384
0:33:55 | 702014 | 13:01:06 | 3385
0:33:56 | 702014 | 13:01:07 | 3386
0:33:57 | 702014 | 13:01:08 | 3387
0:33:58 | 702014 | 13:01:09 | 3388
0:33:59 | 702014 | 13:01:10 | 3389
0:34:00 | 438906 | 13:01:11 | 3390
0:34:01 | 438906 | 13:01:12 | 3391
0:34:02 | 438906 | 13:01:13 | 3392
0:34:03 | 438906 | 13:01:14 | 3393
0:34:04 | 438906 | 13:01:15 | 3394
0:34:05 | 438906 | 13:01:16 | 3395
0:34:06 | 438906 | 13:01:17 | 3396
0:34:07 | 438906 | 13:01:18 | 3397
0:34:08 | 438906 | 13:01:19 | 3398
0:34:09 | 438906 | 13:01:20 | 3399
0:34:10 | 438906 | 13:01:21 | 3400
0:34:11 | 438906 | 13:01:22 | 3401
0:34:12 | 438906 | 13:01:23 | 3402
0:34:13 | 438906 | 13:01:24 | 3403
0:34:14 | 438906 | 13:01:25 | 3404
0:34:15 | 438906 | 13:01:26 | 3405
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
