seethc/IIB_project_FUTURE/rtc_test_files/20260304_2/attiny_log_21h.xlsx

UTC Timestamp | TOTP Code | Elapsed HH:MM:SS | Elapsed (s) | UTC elapsed | CLK elapsed | Elapsed s
0:13:03 | 755224 | 0:00:00 | 0 | 21:14:21 | 21:08:44 | 21:08:44
0:13:05 | 287082 | 0:00:54 | 54
0:13:06 | 287082 | 0:00:55 | 55 | Error | % Error
0:13:07 | 287082 | 0:00:56 | 56 | 0:05:37 | 0.44095%
0:13:08 | 287082 | 0:00:57 | 57
0:13:09 | 287082 | 0:00:58 | 58 | Window | Time till TOTP desync
0:13:10 | 287082 | 0:00:59 | 59 | 1s | 0.002624823297 | 0d00:03:47
0:13:11 | 359152 | 0:01:00 | 60 | 60s | 0.1574893978 | 0d03:46:47
0:13:12 | 359152 | 0:01:01 | 61 | 30m | 4.724681935 | 4d17:23:33
0:13:13 | 359152 | 0:01:02 | 62 | 1h | 9.44936387 | 9d10:47:05
0:13:14 | 359152 | 0:01:03 | 63 | 6h | 56.69618322 | 56d16:42:30
0:13:15 | 359152 | 0:01:04 | 64 | 12h | 113.3923664 | 113d09:25:00
0:13:16 | 359152 | 0:01:05 | 65 | Daily | 226.78 | 226d18:50:01
0:13:17 | 359152 | 0:01:06 | 66
0:13:18 | 359152 | 0:01:07 | 67
0:13:19 | 359152 | 0:01:08 | 68
0:13:20 | 359152 | 0:01:09 | 69
0:13:21 | 359152 | 0:01:10 | 70
0:13:22 | 359152 | 0:01:11 | 71
0:13:23 | 359152 | 0:01:12 | 72
0:13:24 | 359152 | 0:01:14 | 74
0:13:25 | 359152 | 0:01:15 | 75
0:13:26 | 359152 | 0:01:16 | 76
0:13:27 | 359152 | 0:01:17 | 77
0:13:28 | 359152 | 0:01:18 | 78
0:13:29 | 359152 | 0:01:19 | 79
0:13:30 | 359152 | 0:01:20 | 80
0:13:31 | 359152 | 0:01:21 | 81
0:13:32 | 359152 | 0:01:22 | 82
0:13:33 | 359152 | 0:01:23 | 83
0:13:34 | 359152 | 0:01:24 | 84
0:13:35 | 359152 | 0:01:25 | 85
0:13:36 | 359152 | 0:01:26 | 86
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
21:26:58 | 034983 | 21:08:18 | 76098
21:26:59 | 034983 | 21:08:19 | 76099
21:27:00 | 034983 | 21:08:20 | 76100
21:27:01 | 034983 | 21:08:21 | 76101
21:27:02 | 034983 | 21:08:22 | 76102
21:27:03 | 034983 | 21:08:23 | 76103
21:27:04 | 034983 | 21:08:24 | 76104
21:27:05 | 034983 | 21:08:25 | 76105
21:27:06 | 034983 | 21:08:26 | 76106
21:27:07 | 034983 | 21:08:27 | 76107
21:27:08 | 034983 | 21:08:28 | 76108
21:27:09 | 034983 | 21:08:29 | 76109
21:27:10 | 400446 | 21:08:30 | 76110
21:27:11 | 400446 | 21:08:31 | 76111
21:27:12 | 400446 | 21:08:32 | 76112
21:27:13 | 400446 | 21:08:33 | 76113
21:27:14 | 400446 | 21:08:34 | 76114
21:27:15 | 400446 | 21:08:35 | 76115
21:27:16 | 400446 | 21:08:36 | 76116
21:27:17 | 400446 | 21:08:37 | 76117
21:27:18 | 400446 | 21:08:38 | 76118
21:27:19 | 400446 | 21:08:39 | 76119
21:27:20 | 400446 | 21:08:40 | 76120
21:27:22 | 400446 | 21:08:41 | 76121
21:27:23 | 400446 | 21:08:42 | 76122
21:27:24 | 400446 | 21:08:43 | 76123
21:27:25 | 400446 | 21:08:44 | 76124
