seethc/IIB_project_FUTURE/rtc_test_files/20260305/attiny_log_22h.xlsx

UTC Timestamp | TOTP Code | Elapsed HH:MM:SS | Elapsed (s) | UTC elapsed | CLK elapsed | Elapsed s
9:34:00 | 217162 | 9:40:39 | 34839 | 11:39:35 | 11:35:47 | 11:35:47
9:34:01 | 217162 | 9:40:40 | 34840
9:34:02 | 217162 | 9:40:41 | 34841 | Error | % Error
9:34:03 | 217162 | 9:40:42 | 34842 | 0:03:48 | 0.54238%
9:34:04 | 217162 | 9:40:43 | 34843
9:34:05 | 217162 | 9:40:44 | 34844 | Window | Time till TOTP desync
9:34:06 | 217162 | 9:40:45 | 34845 | 1s | 0.002133943505 | 0d00:03:04
9:34:07 | 217162 | 9:40:46 | 34846 | 60s | 0.1280366103 | 0d03:04:22
9:34:08 | 217162 | 9:40:47 | 34847 | 30m | 3.841098309 | 3d20:11:11
9:34:09 | 217162 | 9:40:48 | 34848 | 1h | 7.682196618 | 7d16:22:22
9:34:10 | 217162 | 9:40:49 | 34849 | 6h | 46.09317971 | 46d02:14:11
9:34:11 | 217162 | 9:40:50 | 34850 | 12h | 92.18635941 | 92d04:28:21
9:34:12 | 217162 | 9:40:51 | 34851 | Daily | 184.37 | 184d08:56:43
9:34:13 | 217162 | 9:40:52 | 34852
9:34:14 | 217162 | 9:40:53 | 34853
9:34:15 | 217162 | 9:40:54 | 34854
9:34:16 | 217162 | 9:40:55 | 34855
9:34:17 | 217162 | 9:40:56 | 34856
9:34:18 | 217162 | 9:40:57 | 34857
9:34:19 | 217162 | 9:40:58 | 34858
9:34:20 | 217162 | 9:40:59 | 34859
9:34:21 | 110180 | 9:41:00 | 34860
9:34:22 | 110180 | 9:41:01 | 34861
9:34:23 | 110180 | 9:41:02 | 34862
9:34:24 | 110180 | 9:41:03 | 34863
9:34:25 | 110180 | 9:41:04 | 34864
9:34:26 | 110180 | 9:41:05 | 34865
9:34:27 | 110180 | 9:41:06 | 34866
9:34:28 | 110180 | 9:41:07 | 34867
9:34:30 | 110180 | 9:41:08 | 34868
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
21:13:27 | 257241 | 21:16:19 | 76579
21:13:28 | 257241 | 21:16:20 | 76580
21:13:29 | 257241 | 21:16:21 | 76581
21:13:30 | 257241 | 21:16:22 | 76582
21:13:31 | 257241 | 21:16:23 | 76583
21:13:32 | 257241 | 21:16:24 | 76584
21:13:33 | 257241 | 21:16:25 | 76585
21:13:34 | 257241 | 21:16:26 | 76586
