seethc/IIB_project_FUTURE/rtc_test_files/20260303_2/attiny_log.xlsx

UTC Timestamp | TOTP CODE | Internal CLK TIME | ELAPSED (s) | UTC elapsed | CLK elapsed | Elapsed s
18:58:38 | 755224 | 0:00:00 | 0 | 2:59:06 | 2:58:11 | 2:58:11
18:58:39 | 755224 | 0:00:01 | 1
18:58:40 | 755224 | 0:00:02 | 2 | Error | % Error
18:58:41 | 755224 | 0:00:03 | 3 | 0:00:55 | 0.51619%
18:58:42 | 755224 | 0:00:04 | 4
18:58:43 | 755224 | 0:00:05 | 5 | Window | Time till TOTP desync
18:58:44 | 755224 | 0:00:06 | 6 | 1s | 0.002242220633 | 0d00:03:14
18:58:45 | 755224 | 0:00:07 | 7 | 60s | 0.134533238 | 0d03:13:44
18:58:46 | 755224 | 0:00:08 | 8 | 30m | 4.035997139 | 4d00:51:50
18:58:47 | 755224 | 0:00:09 | 9 | 1h | 8.071994279 | 8d01:43:40
18:58:48 | 755224 | 0:00:10 | 10 | 6h | 48.43196567 | 48d10:22:02
18:58:49 | 755224 | 0:00:11 | 11 | 12h | 96.86393134 | 96d20:44:04
18:58:50 | 755224 | 0:00:12 | 12 | Daily | 193.73 | 193d17:28:07
18:58:51 | 755224 | 0:00:13 | 13
18:58:52 | 755224 | 0:00:14 | 14
18:58:53 | 755224 | 0:00:15 | 15
18:58:55 | 755224 | 0:00:16 | 16
18:58:56 | 755224 | 0:00:17 | 17
18:58:57 | 755224 | 0:00:18 | 18
18:58:58 | 755224 | 0:00:19 | 19
18:58:59 | 755224 | 0:00:20 | 20
18:59:00 | 755224 | 0:00:21 | 21
18:59:01 | 755224 | 0:00:22 | 22
18:59:02 | 755224 | 0:00:23 | 23
18:59:03 | 755224 | 0:00:24 | 24
18:59:04 | 755224 | 0:00:25 | 25
18:59:05 | 755224 | 0:00:26 | 26
18:59:06 | 755224 | 0:00:27 | 27
18:59:07 | 755224 | 0:00:28 | 28
18:59:08 | 755224 | 0:00:29 | 29
18:59:09 | 287082 | 0:00:30 | 30
18:59:10 | 287082 | 0:00:31 | 31
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
19:55:52 | 438906 | 0:56:56 | 3416
19:55:53 | 438906 | 0:56:57 | 3417
19:55:54 | 438906 | 0:56:58 | 3418
19:55:55 | 438906 | 0:56:59 | 3419
19:55:56 | 780546 | 0:57:00 | 3420
19:55:57 | 780546 | 0:57:01 | 3421
19:55:58 | 780546 | 0:57:02 | 3422
19:55:59 | 780546 | 0:57:03 | 3423
19:56:00 | 780546 | 0:57:04 | 3424
19:56:01 | 780546 | 0:57:05 | 3425
19:56:02 | 780546 | 0:57:06 | 3426
19:56:03 | 780546 | 0:57:07 | 3427
19:56:04 | 780546 | 0:57:08 | 3428
19:56:05 | 780546 | 0:57:09 | 3429
19:56:06 | 780546 | 0:57:10 | 3430
19:56:07 | 780546 | 0:57:11 | 3431
19:56:08 | 780546 | 0:57:12 | 3432
19:56:09 | 780546 | 0:57:13 | 3433
19:56:10 | 780546 | 0:57:14 | 3434
19:56:11 | 780546 | 0:57:15 | 3435
19:56:12 | 780546 | 0:57:16 | 3436
19:56:13 | 780546 | 0:57:17 | 3437
19:56:14 | 780546 | 0:57:18 | 3438
19:56:15 | 780546 | 0:57:19 | 3439
19:56:16 | 780546 | 0:57:20 | 3440
19:56:17 | 780546 | 0:57:21 | 3441
19:56:18 | 780546 | 0:57:22 | 3442
19:56:19 | 780546 | 0:57:23 | 3443
19:56:20 | 780546 | 0:57:24 | 3444
19:56:21 | 780546 | 0:57:25 | 3445
19:56:22 | 780546 | 0:57:26 | 3446
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
