seethc/IIB_project_FUTURE/rtc_test_files/20260303_2/totp_log.xlsx

SYS UTC (INTERNET) | TOTP CODE | RTC TIME | ELAPSED (s) | UTC elapsed | RTC elapsed | Elapsed s
19:08:01 | 755224 | 7:35:11 | 0 | 2:49:50 | 2:49:51 | 2:49:51
19:08:01 | 755224 | 7:35:12 | 1
19:08:02 | 755224 | 7:35:13 | 2 | Error | % Error
19:08:03 | 755224 | 7:35:14 | 3 | 0:00:01 | 0.00833%
19:08:04 | 755224 | 7:35:15 | 4
19:08:05 | 755224 | 7:35:16 | 5 | Window | Time till TOTP desync
19:08:06 | 755224 | 7:35:17 | 6 | 1s | 0.1389182126 | 0d03:20:03
19:08:07 | 755224 | 7:35:18 | 7 | 60s | 8.335092756 | 8d08:02:32
19:08:08 | 755224 | 7:35:19 | 8 | 30m | 250.0527827 | 250d01:16:00
19:08:09 | 755224 | 7:35:20 | 9 | 1h | 500.1055654 | 500d02:32:01
19:08:10 | 755224 | 7:35:21 | 10 | 6h | 3000.633392 | 3000d15:12:05
19:08:11 | 755224 | 7:35:22 | 11 | 12h | 6001.266784 | 6001d06:24:10
19:08:12 | 755224 | 7:35:23 | 12 | Daily | 12002.53 | 12002d12:48:20
19:08:13 | 755224 | 7:35:24 | 13
19:08:14 | 755224 | 7:35:25 | 14
19:08:15 | 755224 | 7:35:26 | 15
19:08:16 | 755224 | 7:35:27 | 16
19:08:17 | 755224 | 7:35:28 | 17
19:08:18 | 755224 | 7:35:29 | 18
19:08:19 | 755224 | 7:35:30 | 19
19:08:20 | 755224 | 7:35:31 | 20
19:08:21 | 755224 | 7:35:32 | 21
19:08:22 | 755224 | 7:35:33 | 22
19:08:23 | 755224 | 7:35:34 | 23
19:08:24 | 755224 | 7:35:35 | 24
19:08:25 | 755224 | 7:35:36 | 25
19:08:26 | 755224 | 7:35:37 | 26
19:08:27 | 755224 | 7:35:38 | 27
19:08:28 | 755224 | 7:35:39 | 28
19:08:29 | 755224 | 7:35:40 | 29
19:08:30 | 287082 | 7:35:41 | 30
19:08:31 | 287082 | 7:35:42 | 31
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
19:17:42 | 578337 | 7:44:53 | 582
19:17:43 | 578337 | 7:44:54 | 583
19:17:44 | 578337 | 7:44:55 | 584
19:17:45 | 578337 | 7:44:56 | 585
19:17:46 | 578337 | 7:44:57 | 586
19:17:47 | 578337 | 7:44:58 | 587
19:17:48 | 578337 | 7:44:59 | 588
19:17:49 | 578337 | 7:45:00 | 589
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
