seethc/IIB_project_FUTURE/rtc_test_files/rtc_sync_error_all_runs.png

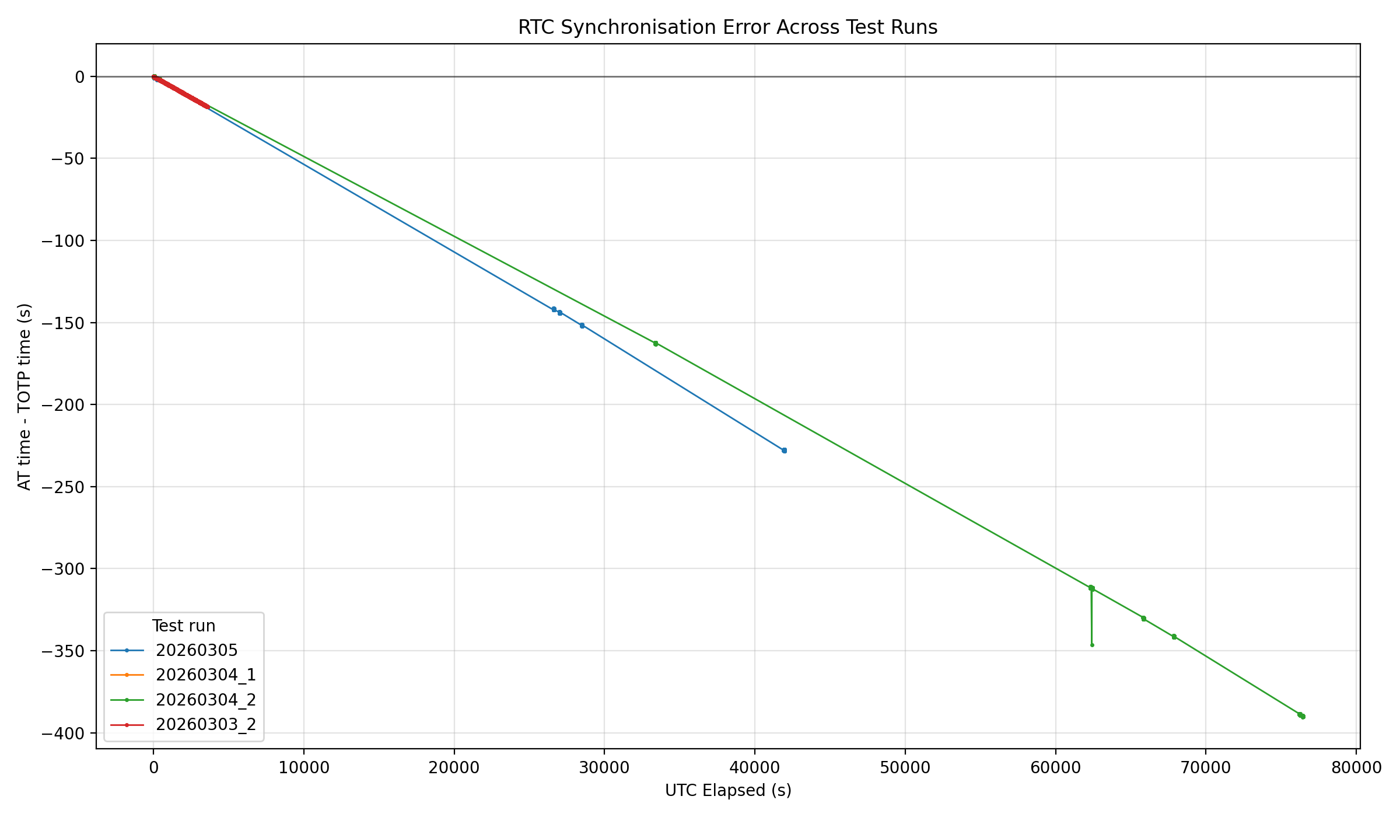
rtc_test_files/rtc_sync_error_all_runs.png
