seethc/IIB_project_FUTURE/VirtualBench_power_tests/plots/current_log_20260326_154908.png

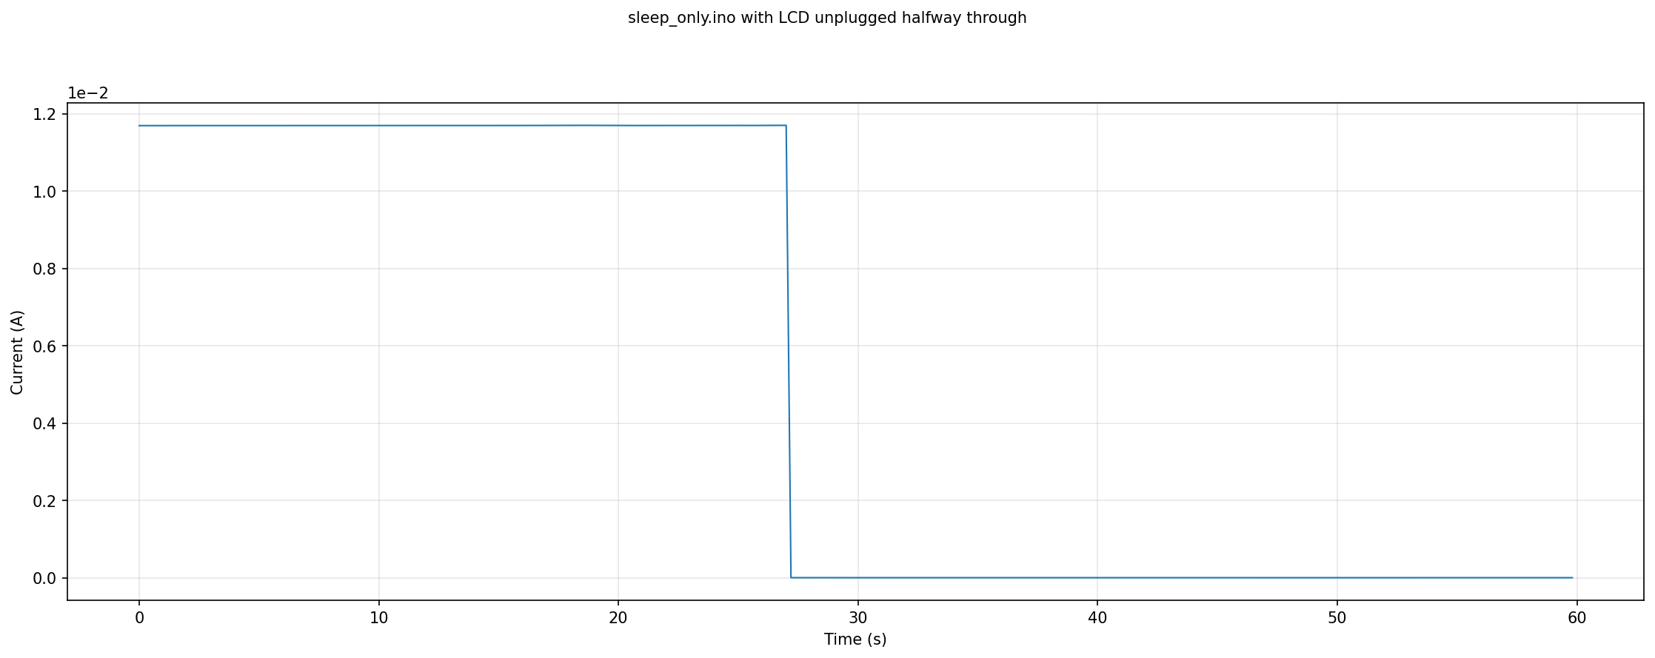
VirtualBench_power_tests/plots/current_log_20260326_154908.png
