seethc/IIB_project_FUTURE/VirtualBench_power_tests/plots/current_log_20260326_164925.png

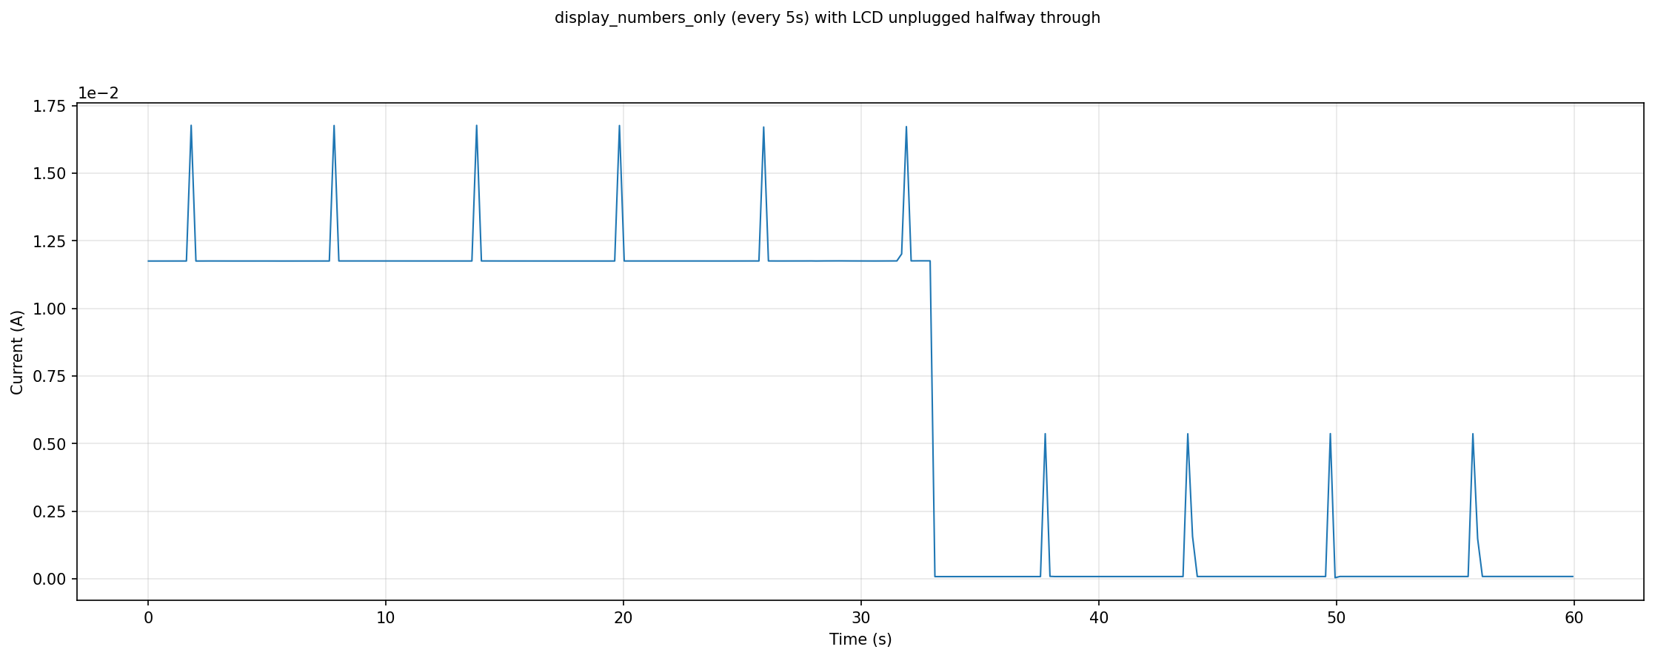
VirtualBench_power_tests/plots/current_log_20260326_164925.png
