seethc/IIB_project_FUTURE/VirtualBench_power_tests/plots/current_log_20260327_162008.png

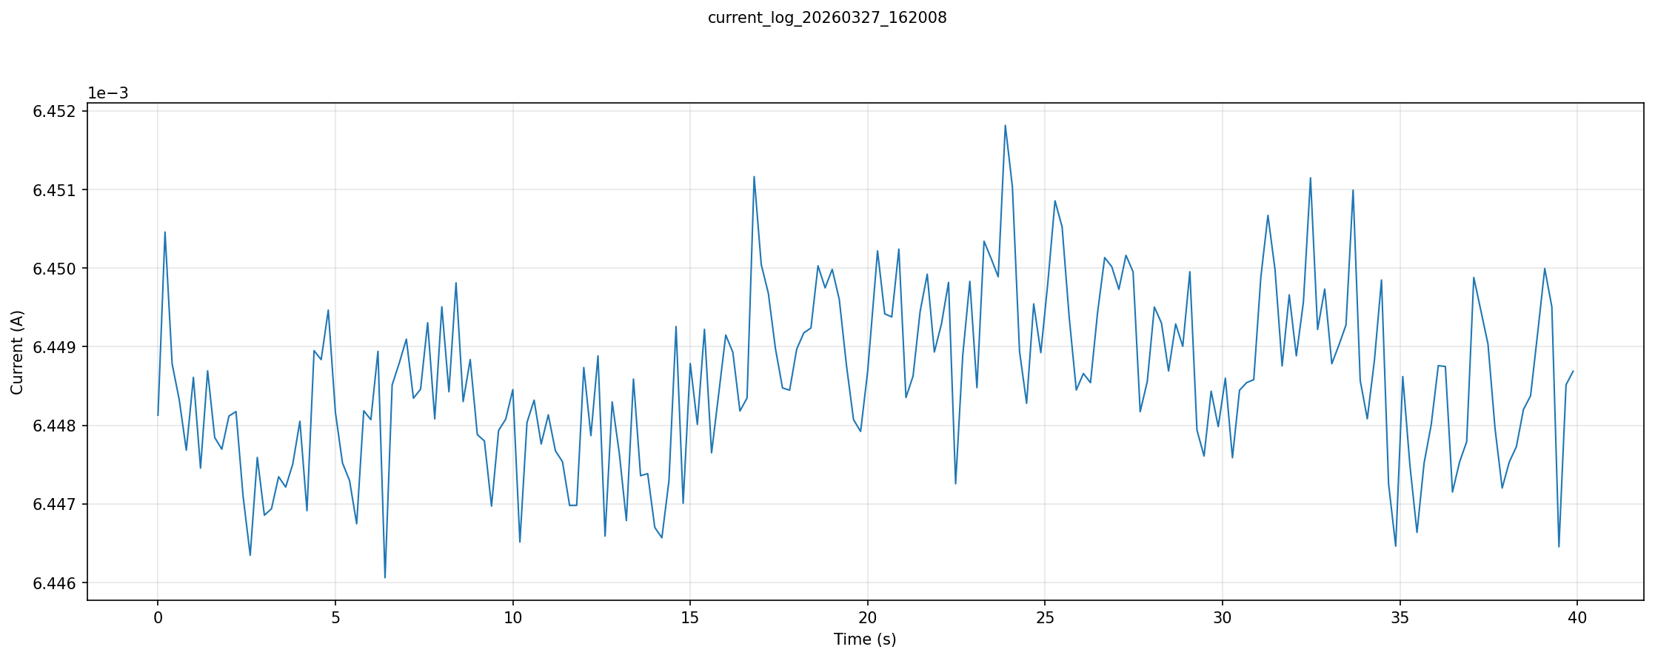
VirtualBench_power_tests/plots/current_log_20260327_162008.png
