seethc/IIB_project_FUTURE/VirtualBench_power_tests/plots/current_log_20260327_163848.png

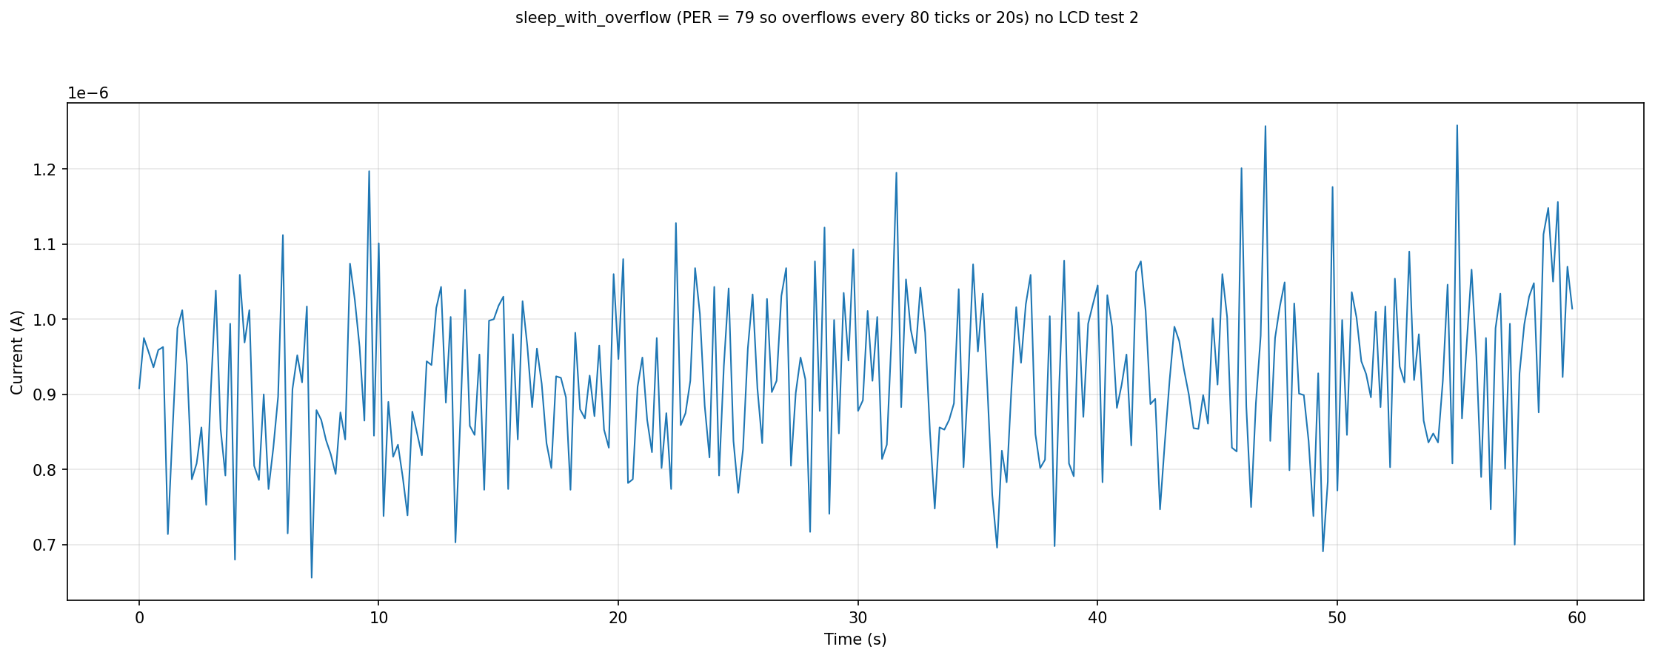
VirtualBench_power_tests/plots/current_log_20260327_163848.png
