seethc/IIB_project_FUTURE/(commit log)

2025-11-07 sleep mode and SHA-1 (lower power version)
2026-02-10 Added Raspberry Pi Python backend scaffold
2026-02-11 added tests, fixed mismatching codes
    [app.py, main.cpp]
2026-02-22 updated pin wiring for LCD
2026-02-23 tested key provisioning via UART
2026-02-23 half-duplex single-wire UART key provisioning test
2026-03-03 added csv logging for rtc sync tests
    [attiny_log.csv, totp_log.csv]
2026-03-03 Pi webapp frontend and backend
    [attiny_log.csv, attiny_log.xlsx, attiny_log_initial_analysis.csv, attiny_log_nortc.csv, totp_log.csv, totp_log.xlsx]
2026-03-03 added script to read UART serial output from AT
2026-03-25 Clock sync test plots
    [ATprocessed.csv, TOTPprocessed.csv, attiny_log.csv, attiny_log_21h.xlsx, attiny_log_22h.xlsx, attiny_log_9h.xlsx, totp_log.csv, totp_log_21h.xlsx]
2026-03-25 Upgraded to ATtiny3216, UART writing, ext. clock
2026-04-09 Power test data analysis python scripts
    [FUTURE Calcs - Power.completed.csv, current_log_20260326_154908.csv, current_log_20260326_155546.csv, current_log_20260326_155758.csv, current_log_20260326_155840.csv, current_log_20260326_160309.csv, current_log_20260326_161021.csv, current_log_20260326_161249.csv]
2026-05-16 RTC sync test plotter script and results
    [ATprocessed.csv, TOTPprocessed.csv, attiny_log.csv, totp_log.csv]
2026-05-19 Power tests for new PCB iteration
    [current_log_20260519_153539.csv, current_log_20260519_153831.csv, current_log_20260519_154000.csv, current_log_20260519_154202.csv, current_log_20260519_154421.csv, current_log_20260519_154529.csv, current_log_20260519_154644.csv, current_log_20260519_154757.csv]
2026-05-21 updated main firmware for new PCB
2026-05-24 complete clinic-side interface implementation (backend and frontend)
    [current_log_20260519_163606.csv]
2026-05-31 final commit
    [3D_PCB_PCB_3216_fob_compact_2026-03-06_2026-03-06.SLDASM, 3D_PCB_PCB_3216_fob_compact_2026-03-06_2026-03-06.SLDDRW, 3D_PCB_PCB_3216_fob_compact_2026-03-06_2026-03-06.step, 3D_PCB_PCB_FUTURE_USB_adapter_2026-03-09_2026-03-09.SLDASM, 3D_PCB_PCB_FUTURE_USB_adapter_2026-03-09_2026-03-09.SLDDRW, 3D_PCB_PCB_FUTURE_USB_adapter_2026-03-09_2026-03-09.step, ATprocessed1.csv, ATprocessed2.csv]
2026-06-12 post-submission edits & Dyson Day prep
    [pendant_rtc_sync_log.csv]
